algorythmics/pianoplayer/hardware/dev_boards/readme.md

# Hardware Development Boards

Replacement for old Escher boards are developed here.
