algorythmics/pianoplayer/hardware/federn/readme.rst

Feder für Rückhol der Hubmagnete
--------------------------------

Kantor
------

Spiralfeder klein (Neuhold standard)

Nachteil: ungenau, laut und schräge Zugkraft

Millittron
----------

ähnlich Kantor

Rhea
----

Black Knight Solenoids
    siehe Fotos

Neue Solenoids

  nach eigenbau mit Klavierdraht #4,
  neue laut zeichnung: formfeder_neu.jpg

    Federstahldraht 1.1211 
    EN 10218-2 Sorte D DIN 17223 T1 
    EN 10270-1DH 207’500 82’500   60° C  

    Alte Federn zu ungenau bei Zug.

  Problem: Materialermüdung (nach 10 Jahren bruch), klemmt leicht

  Neue Federn Faustenhammer
    Kegelstumpf siehe Rechnung und Anbaot
    
    500 Stk erste Serien    
    500 Stk Nachbestellung
