algorythmics/pianoplayer/hardware/escherFET16/readme.rst

escher FET16 - Power FET-Board for escher 1.0
=============================================

algorythmics 6.5.2008, winfried ritsch (see changelog in svn for more)

:board design, first production: Michael Klamminger
:Version: $Revision: 1.0, 1.1 (little modification)

For more info see at [algo_escher]_ 

main features
-------------

- FET-driver ZXGD3002E6  11ns, 9A peak [FETDRIVER]_  for fast switching applications

- 16 N-Channel [FET]_ RTR040N03 30V/4A,16A peak

- usage of ribbon cable connectors

- Voltage regulator for FET-driver supply

- 2 status LEDs

- 2 boards connectable to one escher

- power supply of drivers either externel or from/to escher board

Contents:
---------

board
	eagle board data
	
doc
	collection of documentation on some features
	
figures
	figures, schematics, as images
	
Notes
-----

- Altenative FETs: RSR030n06 60V/3A

.. [algo_escher] homepage: http://algo.mur.at/projects/microcontroller/escher/

.. [FETDRIVER] http://www.diodes.com/products/catalog/detail.php?item-id=820

.. [FET] http://www.rohm.com/products/discrete/transistor/mosfet/rtr040n03/
