algorythmics/pianoplayer/hardware/solenoids/readme.txt

V1:  black knights 7W/12V

V2: Yaxin Sonderfertigung fuer Algorythmics 1000Stk siehe Plan
