algorythmics/pianoplayer/doku/kantor_first_prototype/readme.rst

Kantor
======

First Prototype of Autoklavierspieler, 120kg weight and 3KW of power, played first quadraduren with
Kendrion relais, later Binder-Relais and hand soldered PIC boards on laboratory pcbs.

Schematics is documented in parts, but not whole, also LEDs has been added.

The firmware was written with Michrochips MPLab IDE.

Some Data:

Used solenoids:  Kendrion Gleichstr.Hubmagn. Zyp 40E006-25A58 (24V/8mm) 
 
"Der Gleichstrom-Einfachhubmagnet ist ein Magnet in geschlossener Bauweise mit Anker, gestanztem Bügel und 2 Platten -  ED 100% 24V-13,5W"

KENDRION Binder Magnete Ges.m.b.H, 8552 Eibiswald 269, Austria
