algorythmics/pianoplayer/hardware/escherFET16/docu/readme.txt

furhter documents are under  http://algo.mur.at/projects/microcontroller/escher/devel/fet-experiments
private.

measurement_knights_solenoids
 first measurements pulswith with Resistor and "balck Knights" 12V (100%ED) solenoids on 30V
 
 30V means 16% ED max or 625% of nominal power.
 risetime: 150ns, fall time 100ns allows smallest pulse at 4MHz, which means < 1/200 as first step.
