algorythmics/pianoplayer/hardware/escherFET16/figures/fet16-pinout.pdf

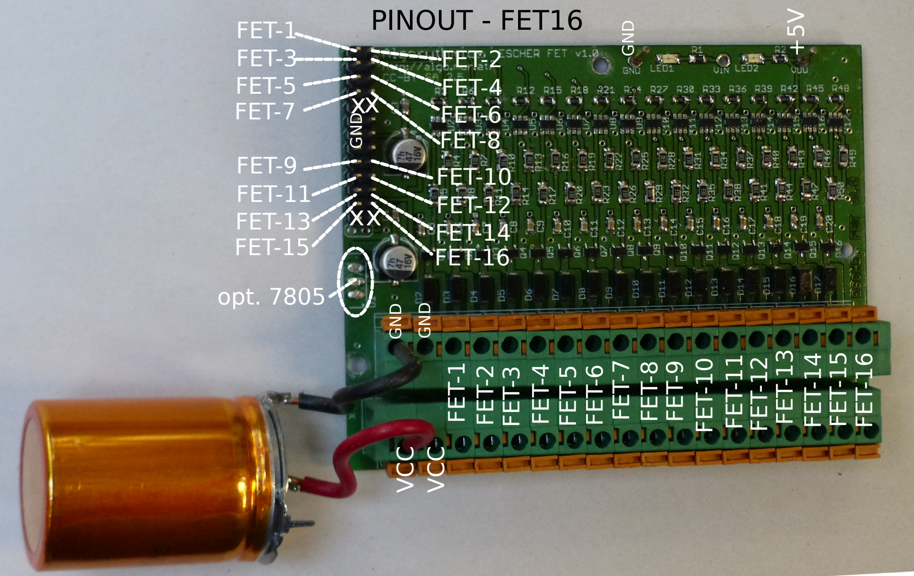
[picture p2: page 1]

FET-1
FET-3
FET-5
FET-7

FET-9
FET-11
FET-13
FET-15

### xxGND

FET-2
FET-4
FET-6
FET-8
FET-10
FET-12
FET-14

# FET-16 FET⁻1 FET⁻3

FET-5

FET-7
FET-9
FET-2

FET-4
FET-6

FET-8

FET-10

FET-11
FET-12

FET-13
FET-14

FET-15
FET-16

### VCC GND

## GND VCC

GND

+5V

xx

### PINOUT - FET16

opt. 7805
