algorythmics/pianoplayer/doku/idea_of_a_piano_space.pdf

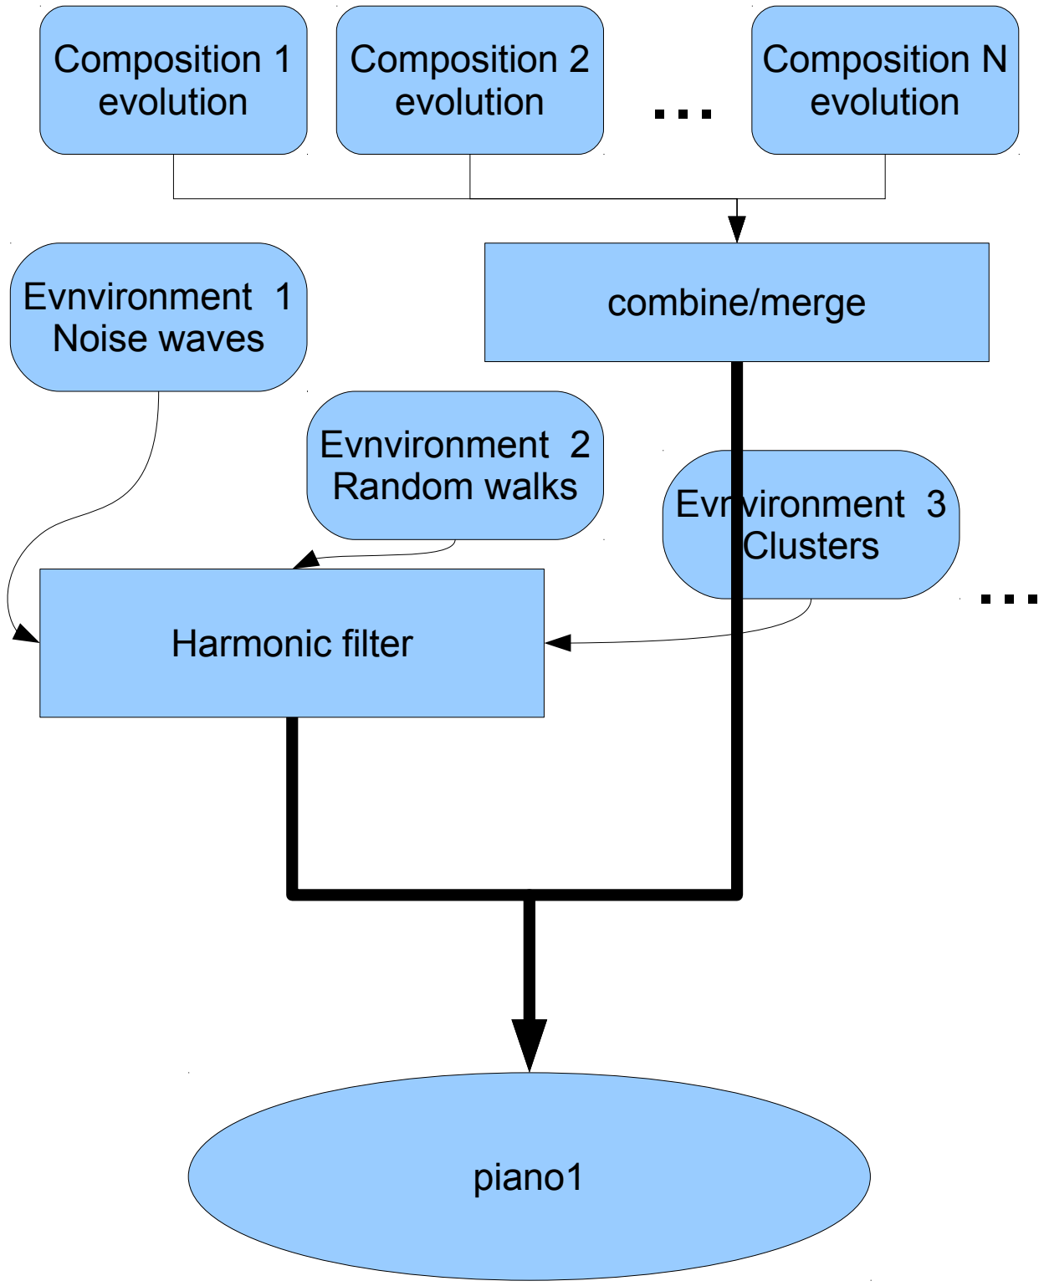
[picture p3: figure]
piano1; Composition 1 evolution; Composition 2; evolution; Composition N evolution; Evnvironment 1 Noise waves; Evnvironment 2; Random walks; Evnvironment 3; Clusters; combine/merge; Harmonic filter

One piano space for parallel pieces

voices
