algorythmics/pianoplayer/hardware/solenoids/hubmagnete_messurements-for_firmware.ods

Sheet: calculations
Watt und Leistung
7 W Hubmagnet 12V |  |  |  |  |  | 4 W Hubmagnet -12V
 | U | P (W) | R | I |  |  | U | P (W) | R | I
Angabe | 12 | 7 | 20,5714285714 | 0,5833333333 |  | Angabe | 12 | 4 | 36 | 0,3333333333
Bei | 30 | 43,75 | 20,5714285714 | 1,4583333333 | 16,00% | Bei | 30 | 25 | 36 | 0,8333333333 | 16,00%
 | 20 | 19,4444444444 | 20,5714285714 | 0,9722222222 |  |  | 20 | 11,1111111111 | 36 | 0,5555555556
 | 32 | 49,7777777778 | 20,5714285714 | 1,5555555556 |  |  | 32 | 28,4444444444 | 36 | 0,8888888889
7 W Hubmagnet – 6V |  |  |  |  |  | 4 W Hubmagnet – 6V
 | U | P (W) | R | I (A) |  |  | U | P (W) | R | I
Angabe | 6 | 7 | 5,1428571429 | 1,1666666667 |  | Angabe | 6 | 4 | 9 | 0,6666666667
Bei | 30 | 175 | 5,1428571429 | 5,8333333333 | 4,00% | Bei | 30 | 100 | 9 | 3,3333333333 | 4,00%
 | 20 | 77,7777777778 | 5,1428571429 | 3,8888888889 |  |  | 20 | 44,4444444444 | 9 | 2,2222222222
 | 16 | 49,7777777778 | 5,1428571429 | 3,1111111111 |  |  | 32 | 113,7777777778 | 9 | 3,5555555556
Impuls |  | 10 | 50 | 20,00%
 |  |  | Ieinzel(A) | I(A) | U(V) | P (W)
Gesamt Leistung |  |  | 3 | 264 | 16 | 4224
 |  |  |  | 52,8 | 16 | 422,4
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
