algorythmics/pianoplayer/doku/kantor_first_prototype/Idee-Steuerung.pdf

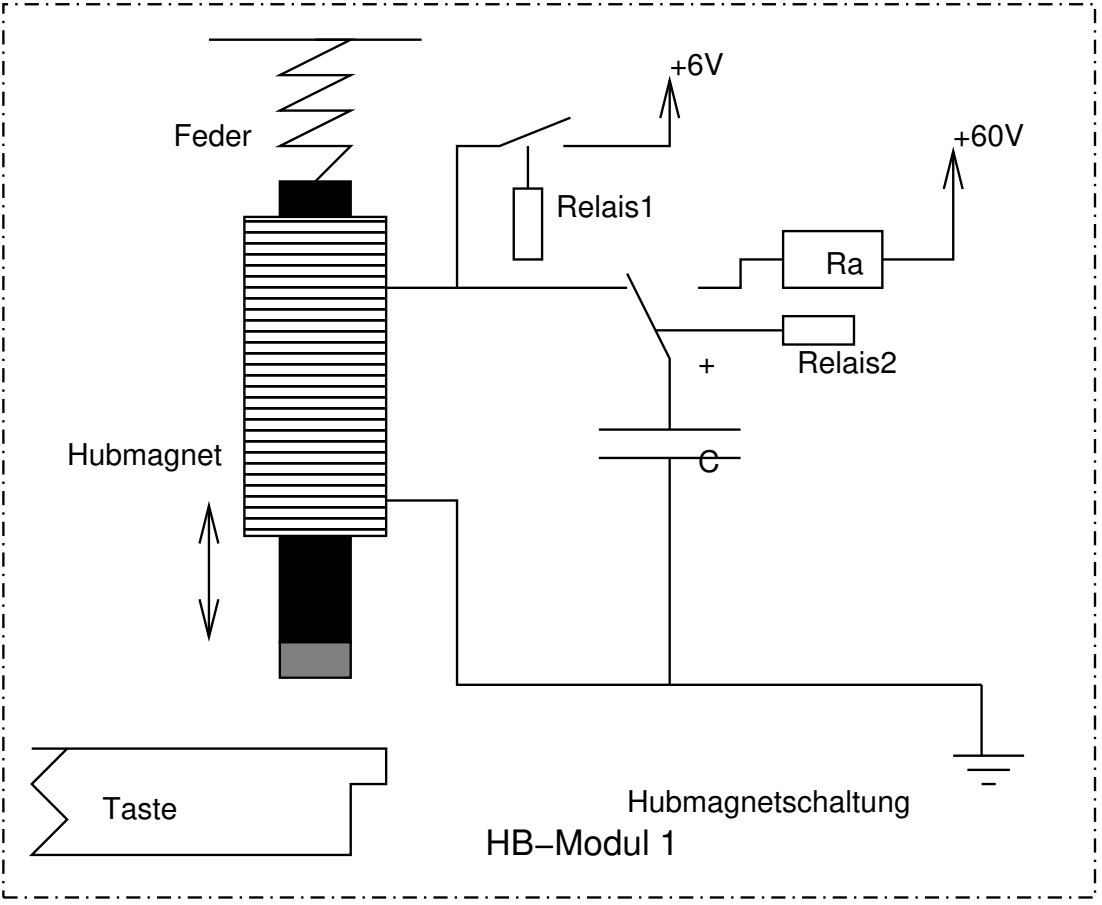
[picture p4: figure]
Taste; Feder; Hubmagnet; Relais1; Relais2; Hubmagnetschaltung HB−Modul 1
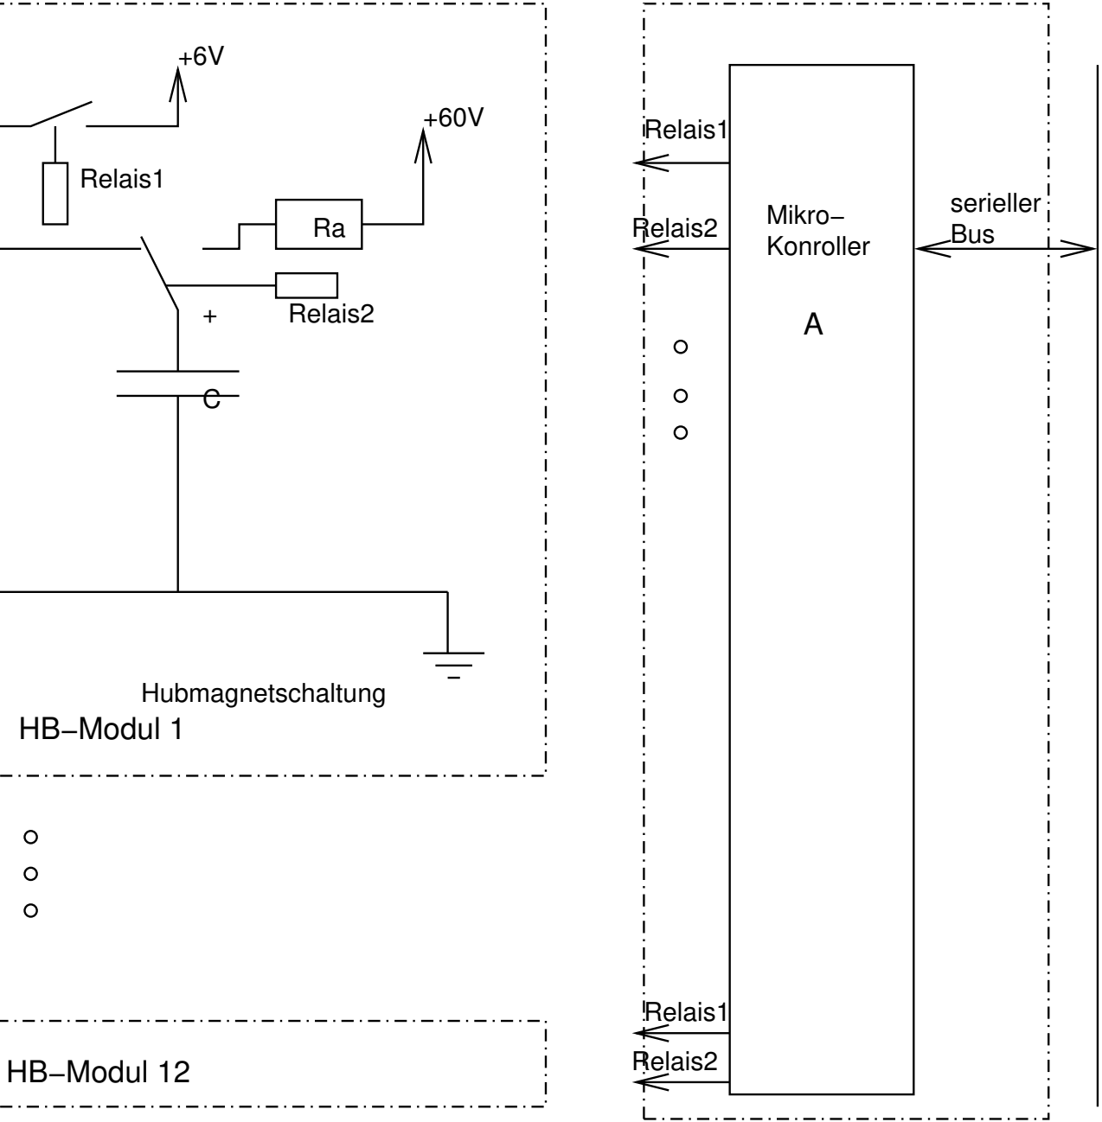
[picture p5: figure]
Mikro− Konroller Relais2; Relais1; serieller Bus; HB−Modul 12; Relais2
