algorythmics/pianoplayer/hardware/doku/tastenabstaende.ods

Sheet: Allgemein
Einheiten
 | mm | Tastenbreiten | Tastenbreiten | Tastenbreiten | Tastenbreiten
 | je inch | bei 85 Tasten | je Oktave | 7 Oktaven | bei 88 Tasten
 | 25,4 | 50 | 7 | 49 | 52
Format | inch/Octave | inch/Taste | inch / 85 Tasten | mm/Octave | mm/Taste | mm/85 Tasten | mm/88Tasten
Standard | 6,5 | 0,93 | 46,43 | 165,1 | 23,5857 | 1155,7 | 1226,46
gemessen | 6,48 | 0,93 | 46,26 | 164,5 | 23,5000 | 1182 | 1222 | Yamaha
SD Standard | 6 | 0,86 | 42,86 | 152,4 | 21,7714 | 1066,8 | 1132,11
small | 5,11 | 0,73 | 36,5 | 129,79 | 18,5420 | 908,56 | 964,18
large | 7,04 | 1,01 | 50,29 | 178,82 | 25,5451 | 1251,71 | 1328,35
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
