algorythmics/pianoplayer/doku/kantor_first_prototype/fotos/00b_first_version-microcontroller_pic16f877.jpg

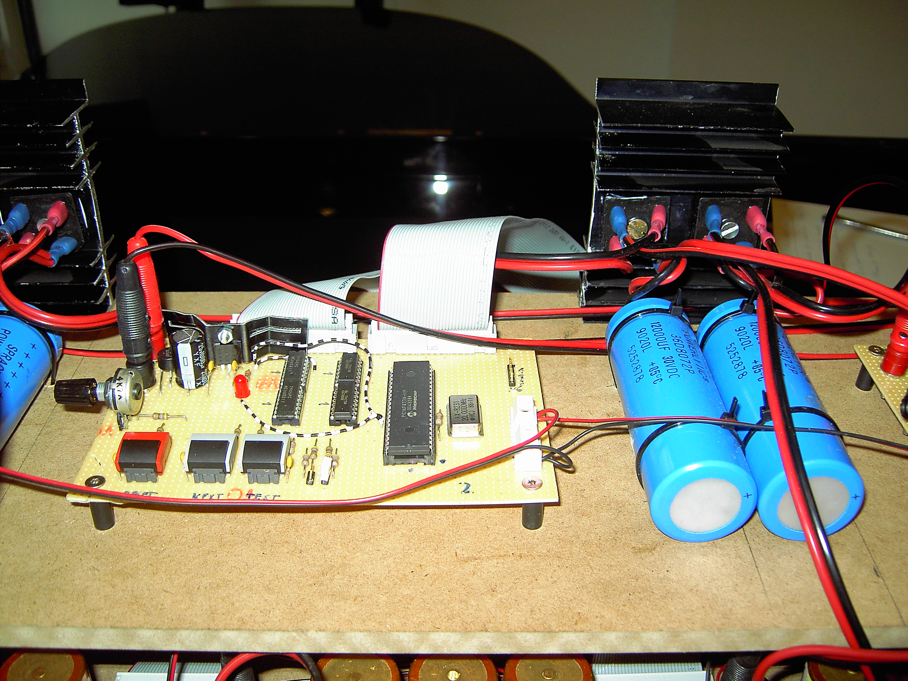
doku/kantor_first_prototype/fotos/00b_first_version-microcontroller_pic16f877.jpg
