algorythmics/pianoplayer/doku/kantor_first_prototype/fotos/00c-FET-board_for_one_octavepict0019.jpg

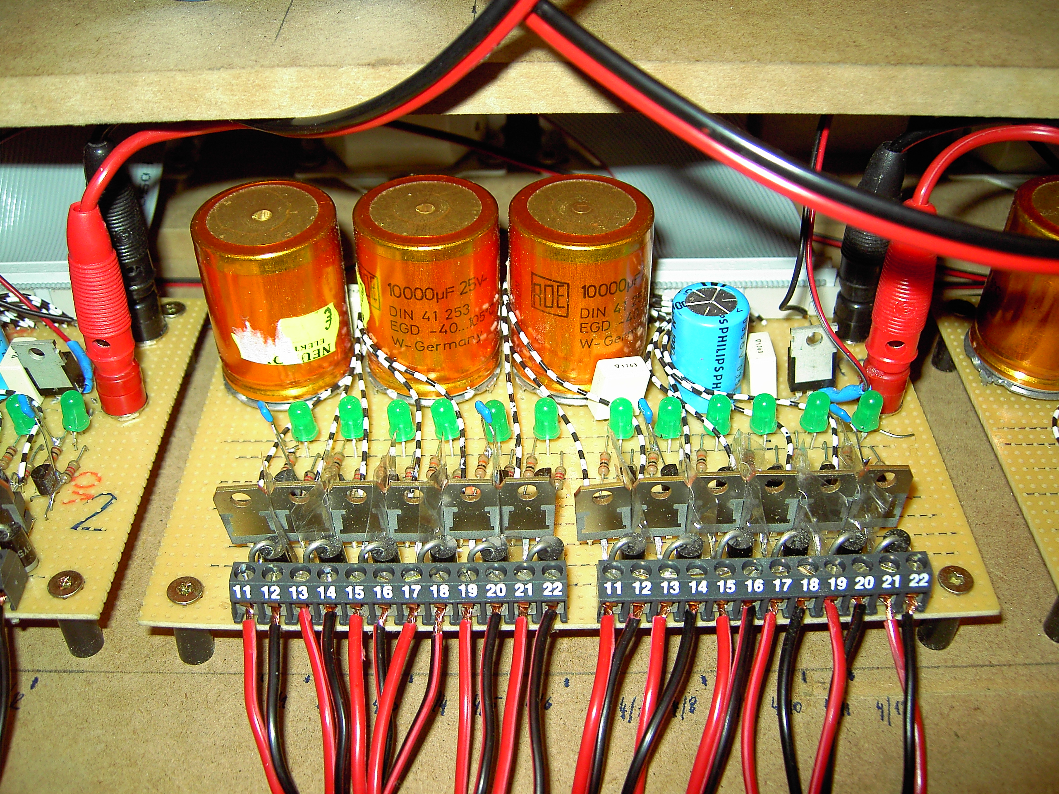
doku/kantor_first_prototype/fotos/00c-FET-board_for_one_octavepict0019.jpg
