algorythmics/pianoplayer/doku/kantor_first_prototype/fotos/00d-firstfinger_with_platic_tips.jpg

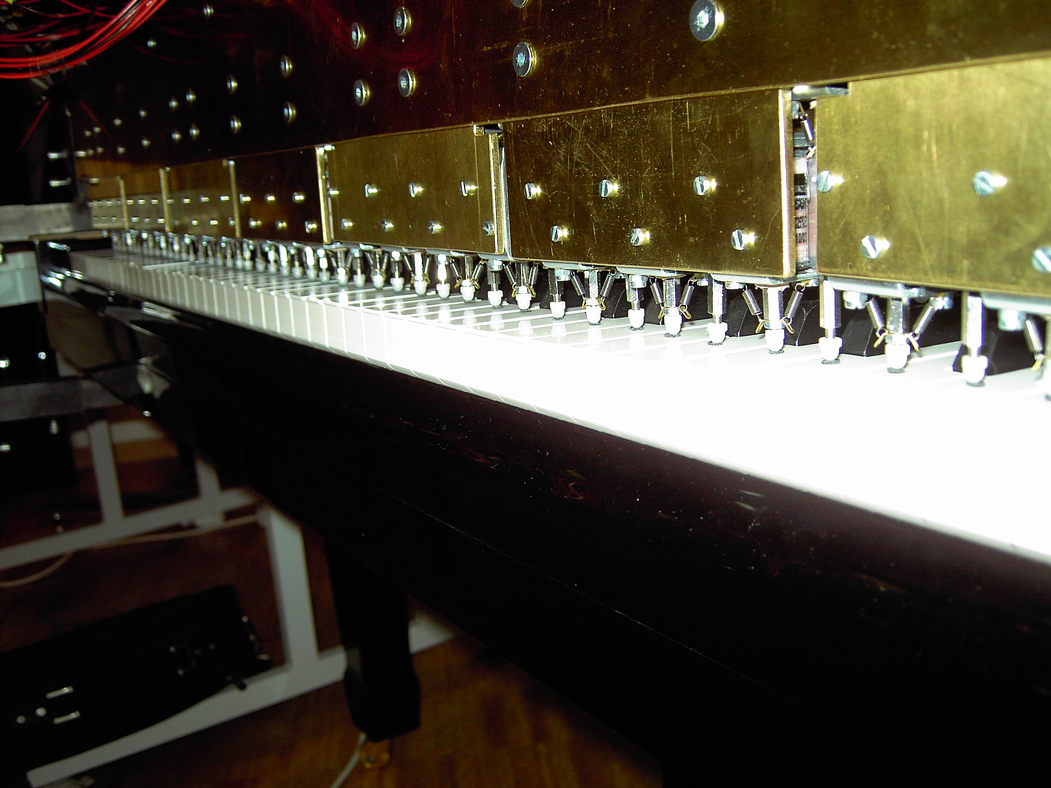
doku/kantor_first_prototype/fotos/00d-firstfinger_with_platic_tips.jpg
