algorythmics/pianoplayer/doku/kantor_first_prototype/fotos/00e-after_first_experiements.jpg

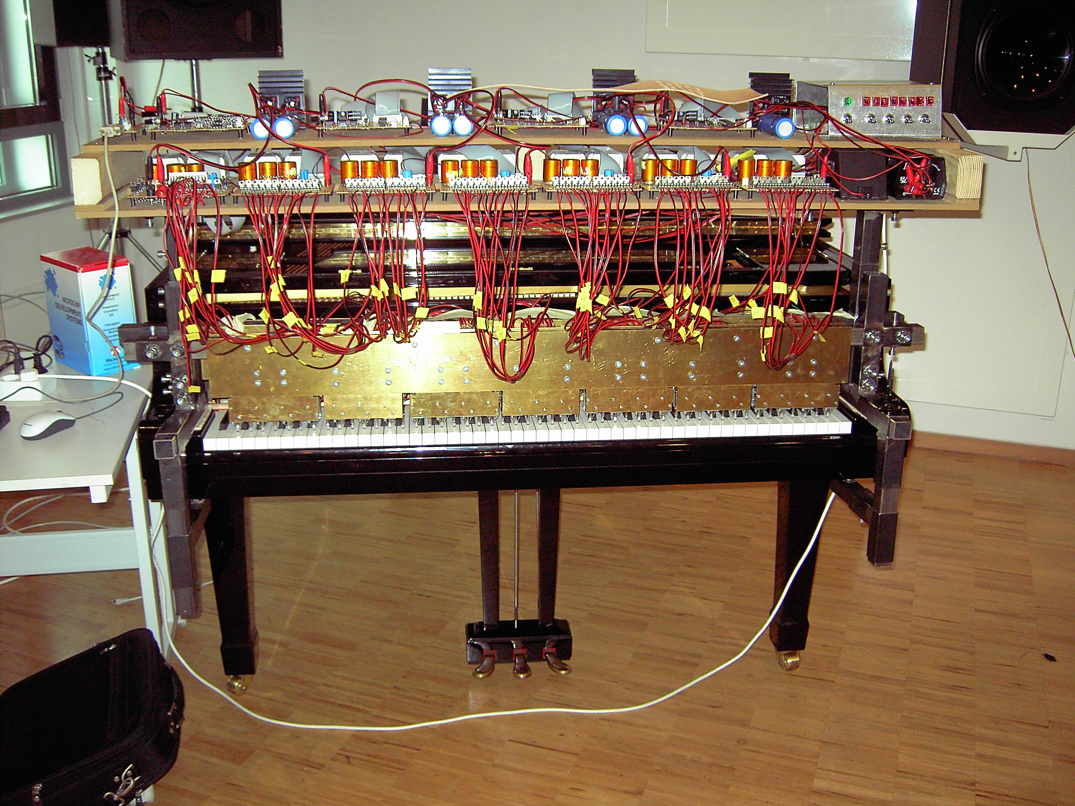
doku/kantor_first_prototype/fotos/00e-after_first_experiements.jpg
