algorythmics/pianoplayer/doku/kantor_first_prototype/fotos/01a-first_playing_prototype_for_prgrammung.jpg

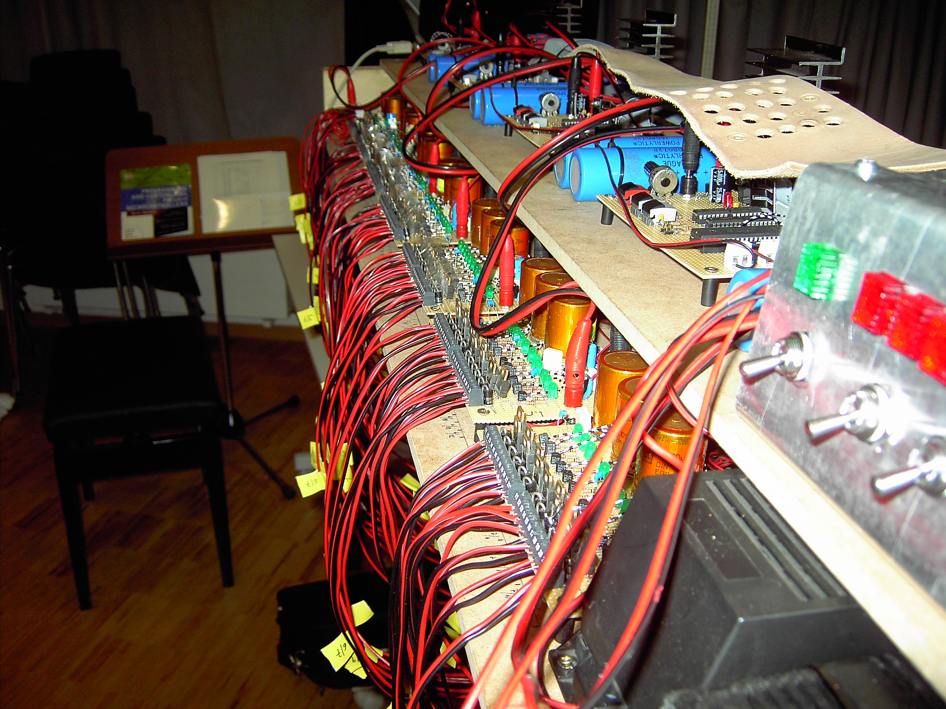
doku/kantor_first_prototype/fotos/01a-first_playing_prototype_for_prgrammung.jpg
