algorythmics/pianoplayer/doku/kantor_first_prototype/fotos/01b-new-brass_finger_with_felt.jpg

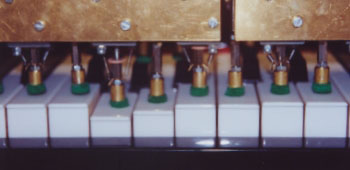
doku/kantor_first_prototype/fotos/01b-new-brass_finger_with_felt.jpg
