algorythmics/pianoplayer/doku/kantor_first_prototype/fotos/01c-finger_mounted_for_each_octave.jpg

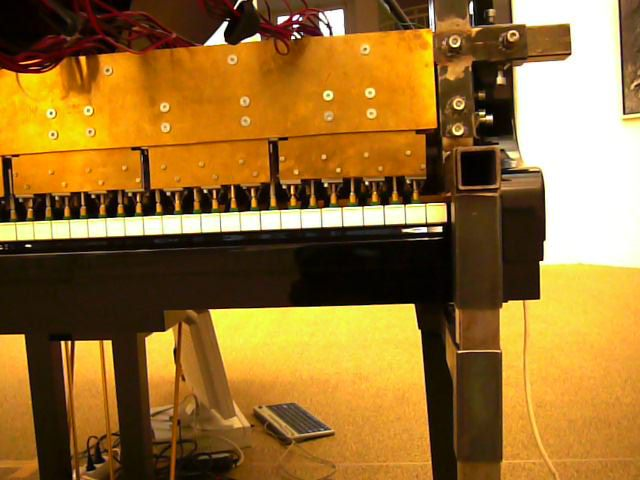
doku/kantor_first_prototype/fotos/01c-finger_mounted_for_each_octave.jpg
