algorythmics/pianoplayer/doku/kantor_first_prototype/fotos/01d-prepared_for_first_concert.jpg

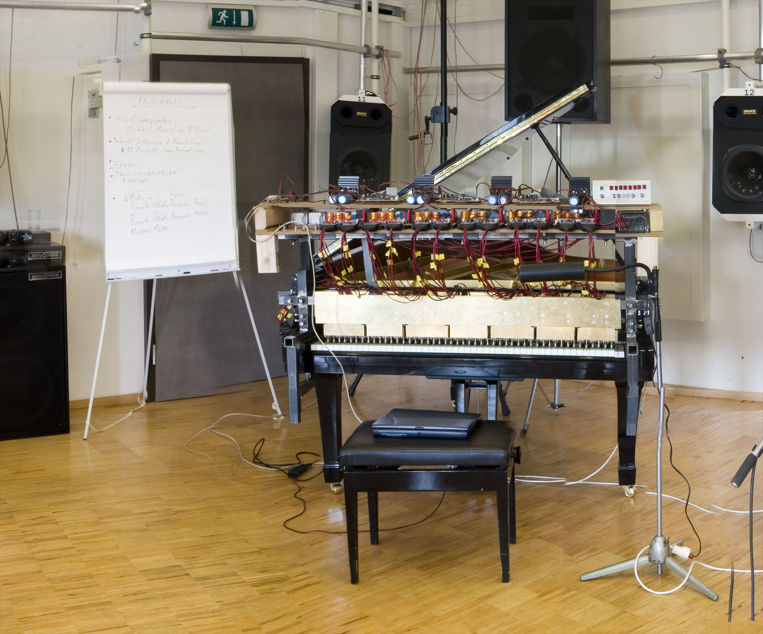
doku/kantor_first_prototype/fotos/01d-prepared_for_first_concert.jpg
