algorythmics/pianoplayer/doku/kantor_first_prototype/fotos/02-concert_in_minoriten_as_premiere.jpg

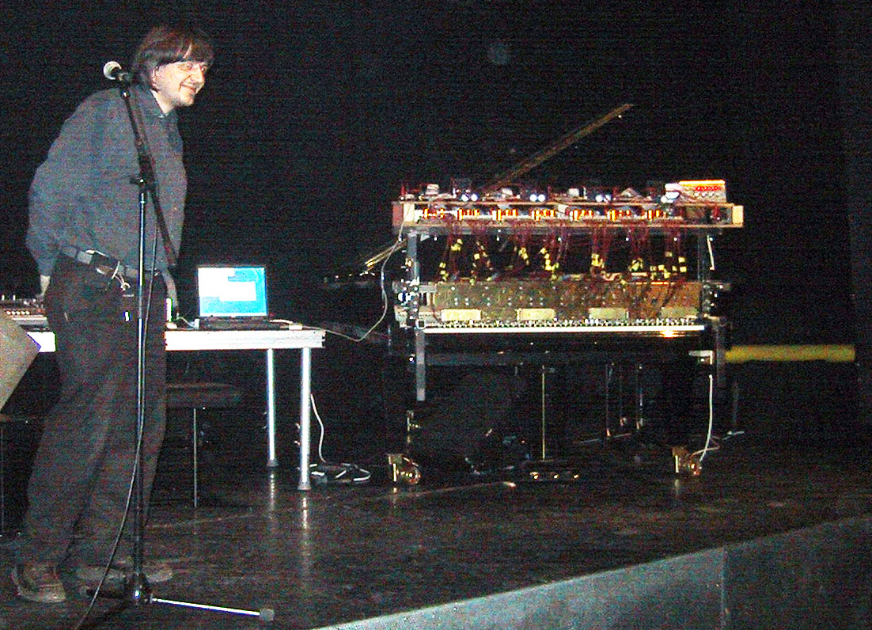
doku/kantor_first_prototype/fotos/02-concert_in_minoriten_as_premiere.jpg
