algorythmics/pianoplayer/doku/kantor_first_prototype/fotos/03a-playing_on_stage_in_listhalle_for_opera.jpg

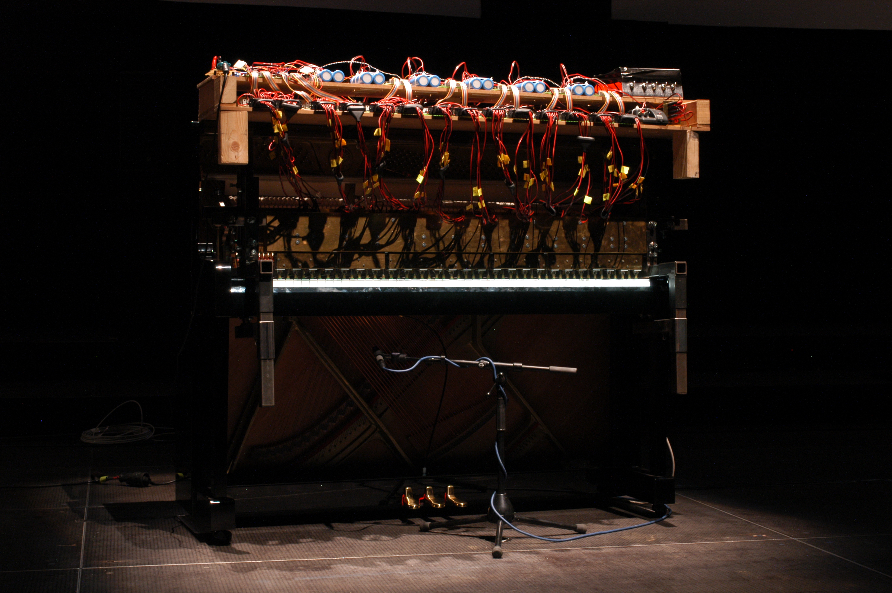
doku/kantor_first_prototype/fotos/03a-playing_on_stage_in_listhalle_for_opera.jpg
