algorythmics/pianoplayer/doku/kantor_first_prototype/fotos/03c-playing_on_stage_in_listhalle_with_movie.jpg

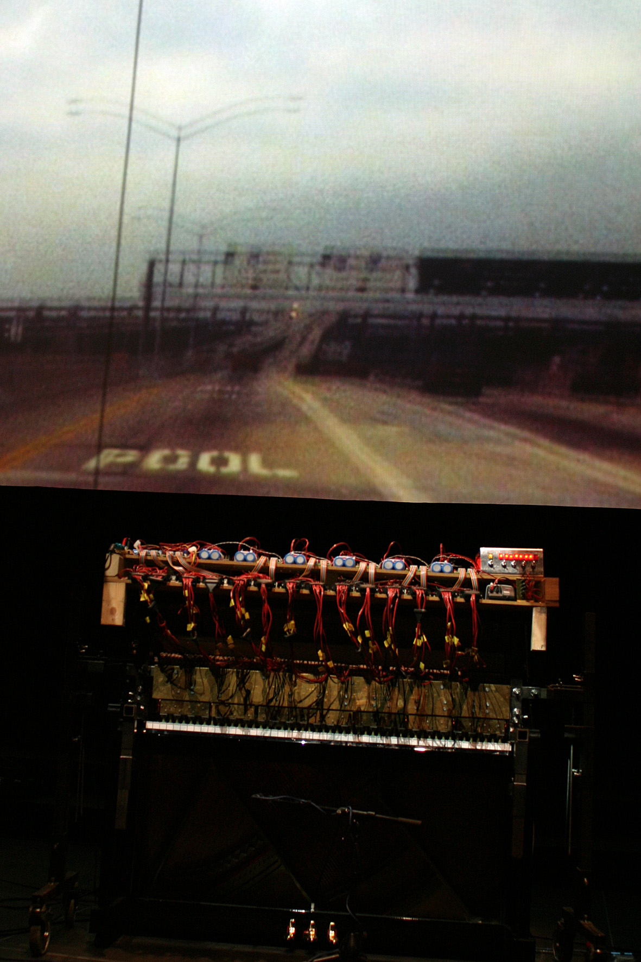
doku/kantor_first_prototype/fotos/03c-playing_on_stage_in_listhalle_with_movie.jpg
