algorythmics/pianoplayer/doku/kantor_first_prototype/fotos/03d-playing_on_stage_in_listhalle_with-ensembles_and_millitron.jpg

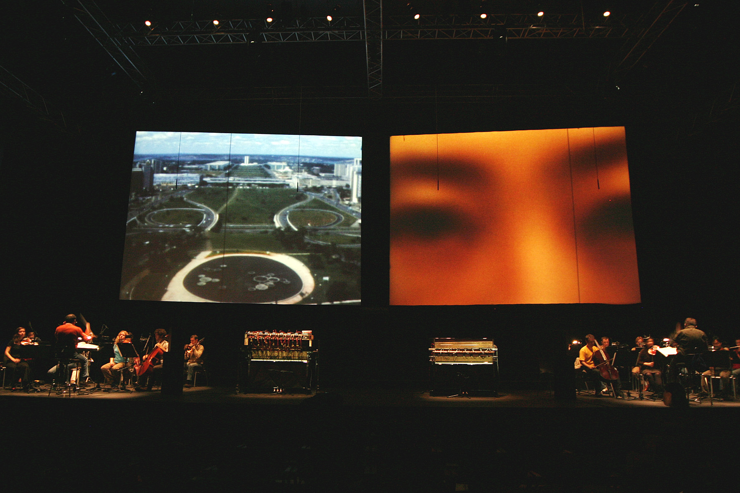
doku/kantor_first_prototype/fotos/03d-playing_on_stage_in_listhalle_with-ensembles_and_millitron.jpg
