algorythmics/pianoplayer/doku/kantor_first_prototype/fotos/04-playing_interactive_in_kunsthaus-graz.jpg

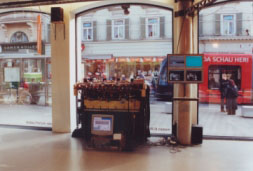
doku/kantor_first_prototype/fotos/04-playing_interactive_in_kunsthaus-graz.jpg
