algorythmics/pianoplayer/doku/kantor_first_prototype/schaltungen_entwurf/icdconnect.png

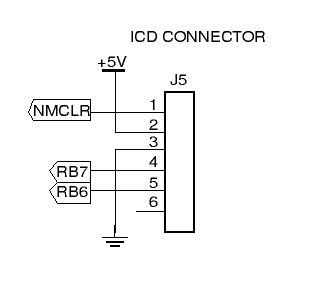
doku/kantor_first_prototype/schaltungen_entwurf/icdconnect.png
