algorythmics/pianoplayer/doku/kantor_first_prototype/schaltungen_entwurf/oszi.png

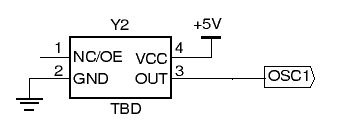
doku/kantor_first_prototype/schaltungen_entwurf/oszi.png
