algorythmics/pianoplayer/doku/kantor_first_prototype/schaltungen_entwurf/PIC16F877Apinout.png

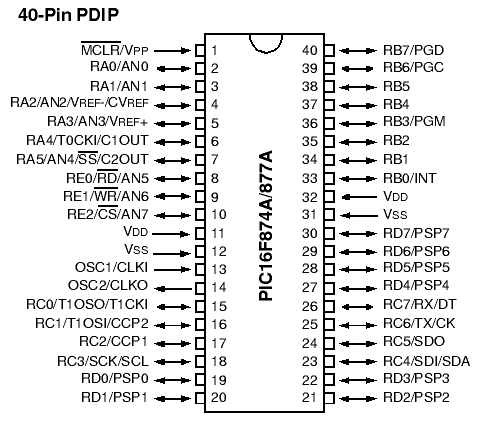
doku/kantor_first_prototype/schaltungen_entwurf/PIC16F877Apinout.png
