algorythmics/pianoplayer/doku/kantor_first_prototype/schaltungen_entwurf/schalter_ra_port.png

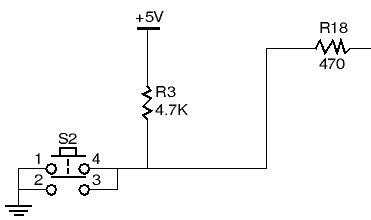
doku/kantor_first_prototype/schaltungen_entwurf/schalter_ra_port.png
