algorythmics/pianoplayer/doku/kantor_first_prototype/schaltungen_entwurf/schalter_reset.png

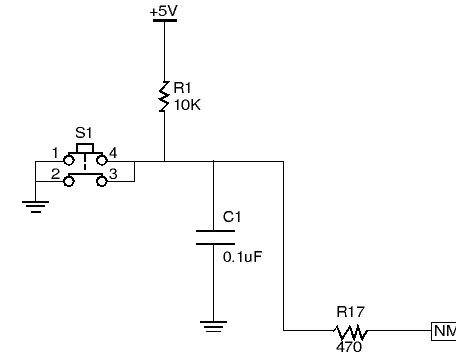
doku/kantor_first_prototype/schaltungen_entwurf/schalter_reset.png
