algorythmics/pianoplayer/doku/kantor_first_prototype/schaltungen_entwurf/seriell.png

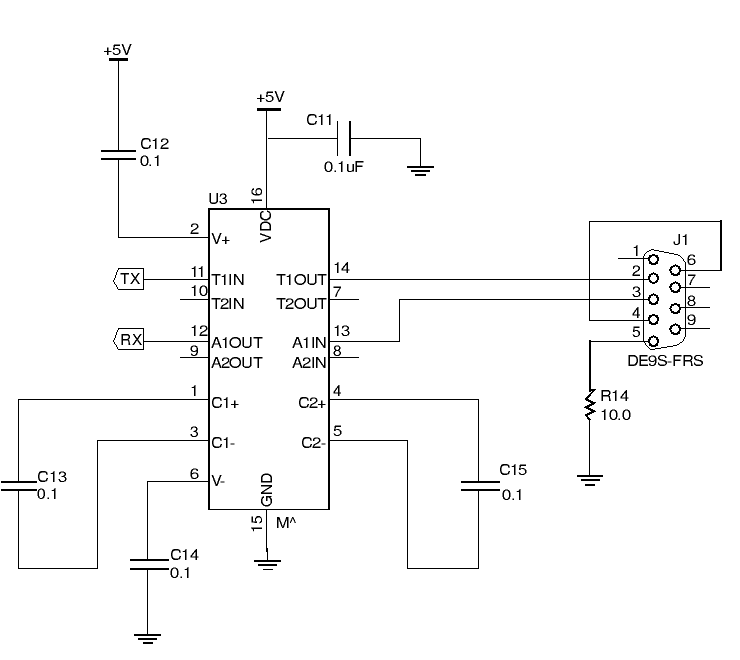
doku/kantor_first_prototype/schaltungen_entwurf/seriell.png
