algorythmics/pianoplayer/doku/kantor_first_prototype/schaltungen_entwurf/versorgung.png

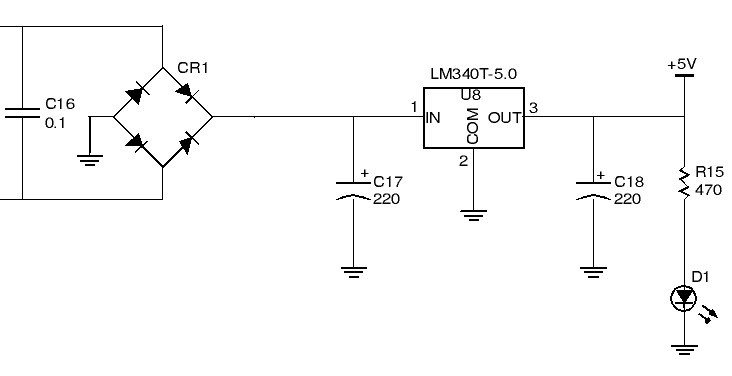
doku/kantor_first_prototype/schaltungen_entwurf/versorgung.png
