algorythmics/pianoplayer/doku/millitron_2nd_generation/fotos/02-listhalle_millitron.jpg

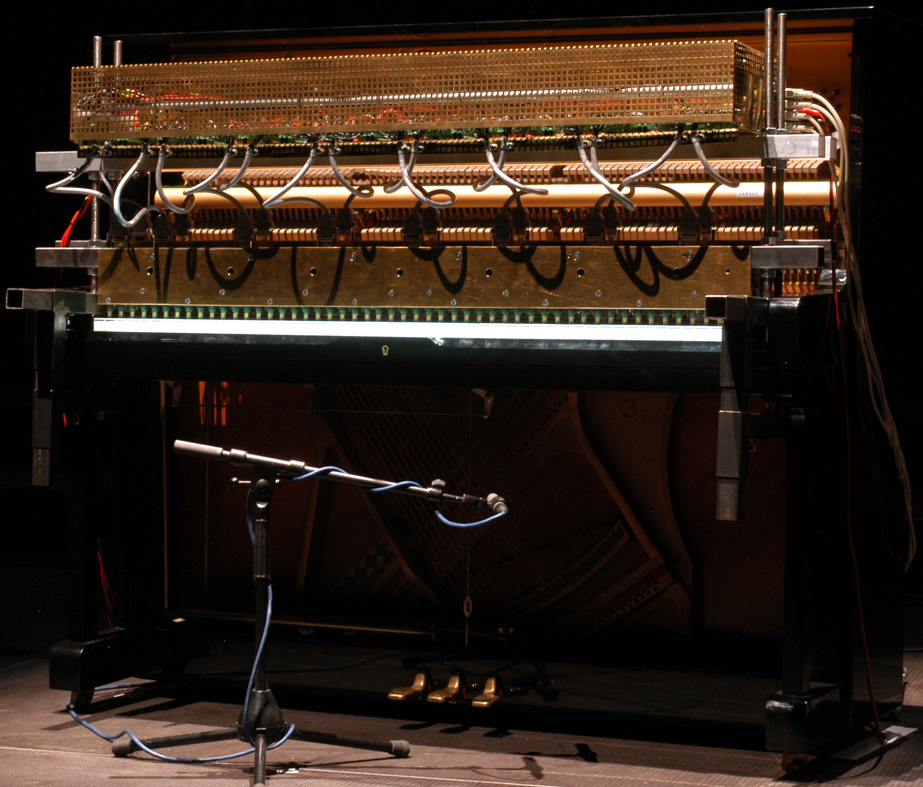
doku/millitron_2nd_generation/fotos/02-listhalle_millitron.jpg
