algorythmics/pianoplayer/doku/millitron_2nd_generation/fotos/03-finger.jpg

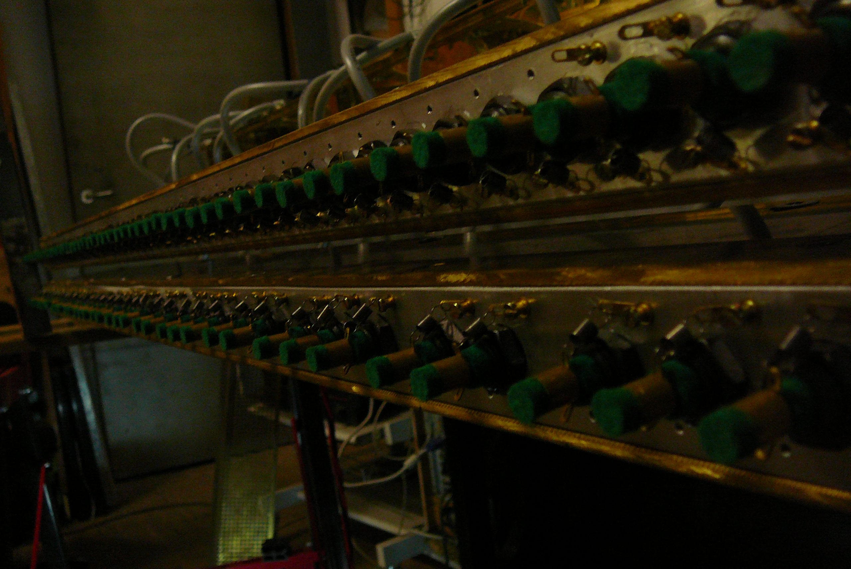
doku/millitron_2nd_generation/fotos/03-finger.jpg
