algorythmics/pianoplayer/doku/millitron_2nd_generation/fotos/04a-millitron_in_witten.jpg

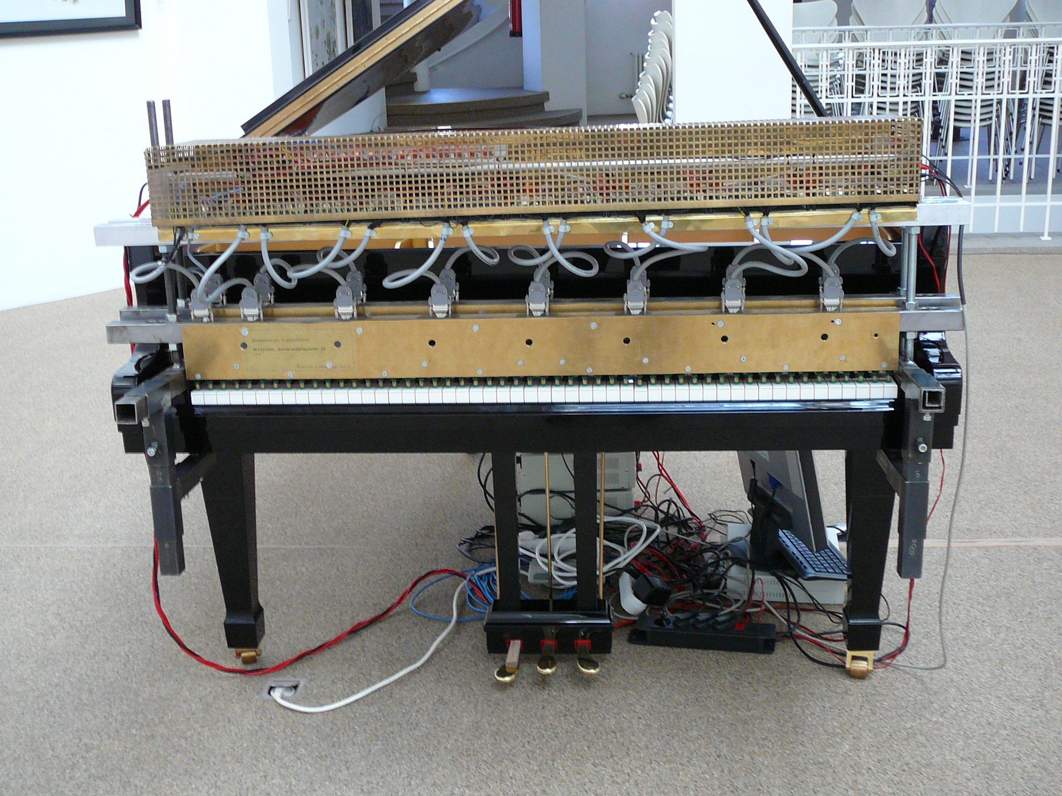
doku/millitron_2nd_generation/fotos/04a-millitron_in_witten.jpg
