algorythmics/pianoplayer/doku/millitron_2nd_generation/fotos/04c-millitron_in_witten_with_kantor.jpeg

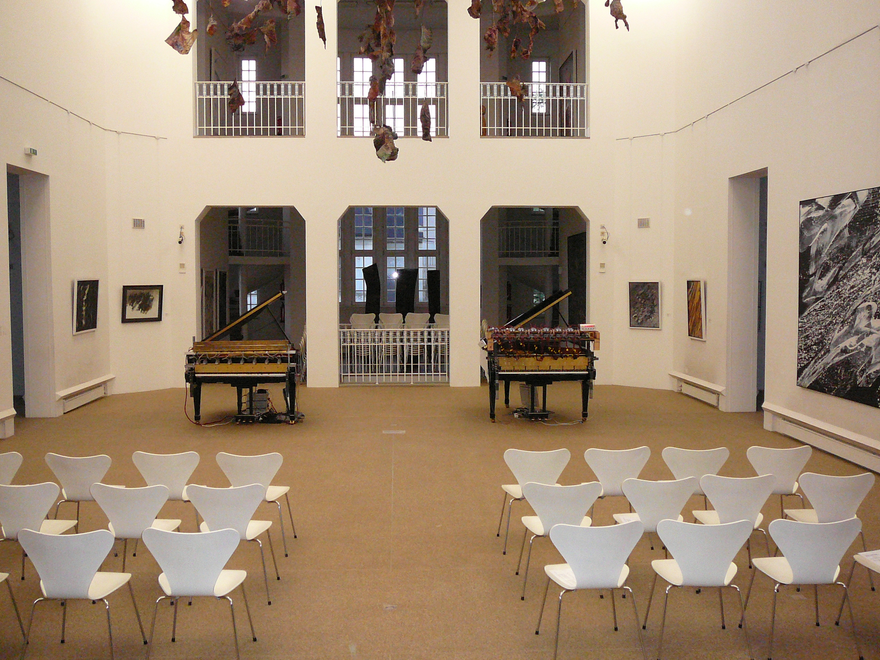
doku/millitron_2nd_generation/fotos/04c-millitron_in_witten_with_kantor.jpeg
