algorythmics/pianoplayer/doku/millitron_2nd_generation/fotos/04d-millitron_in_witten_with_kantor.jpg

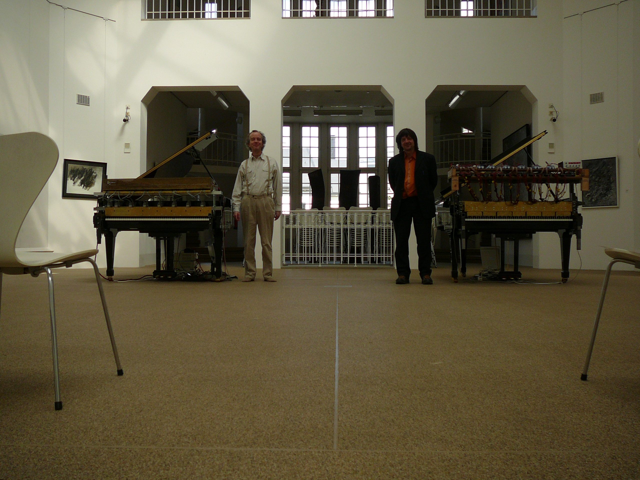
doku/millitron_2nd_generation/fotos/04d-millitron_in_witten_with_kantor.jpg
