algorythmics/pianoplayer/doku/one-hammer-piano_player-demo/IMG_20240417_135547.jpg

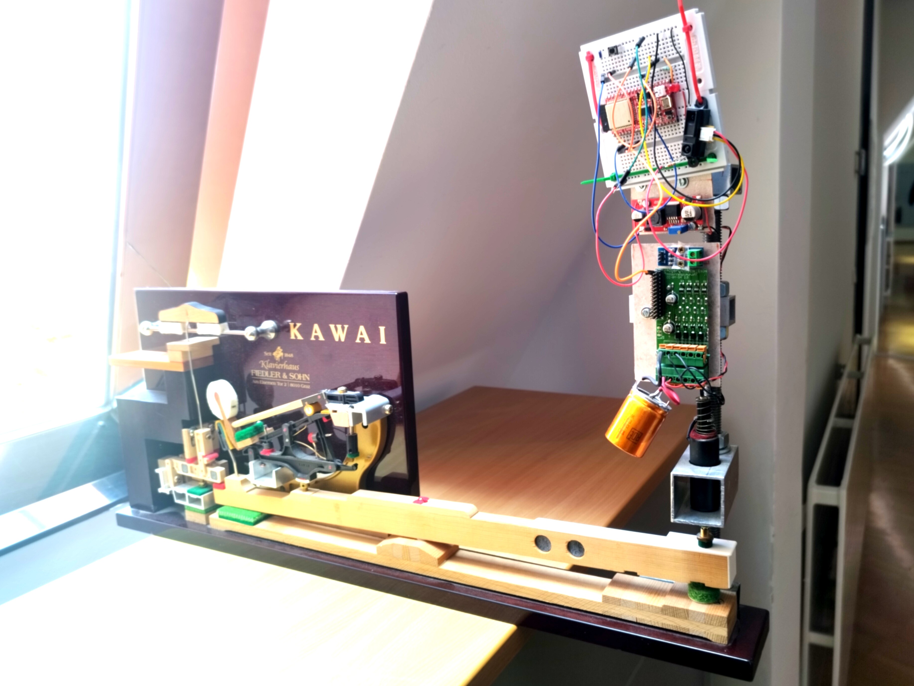
doku/one-hammer-piano_player-demo/IMG_20240417_135547.jpg
