algorythmics/pianoplayer/doku/rhea_3rd_generation/fotos/00d-rhea_v1-finger.jpg

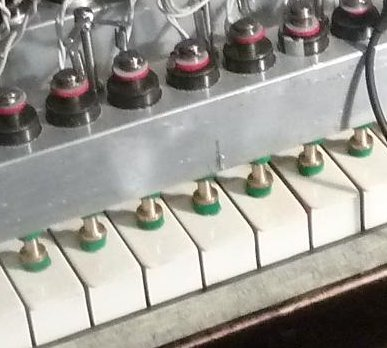
doku/rhea_3rd_generation/fotos/00d-rhea_v1-finger.jpg
