algorythmics/pianoplayer/doku/rhea_3rd_generation/fotos/00e-rhea_v1-prototype.jpg

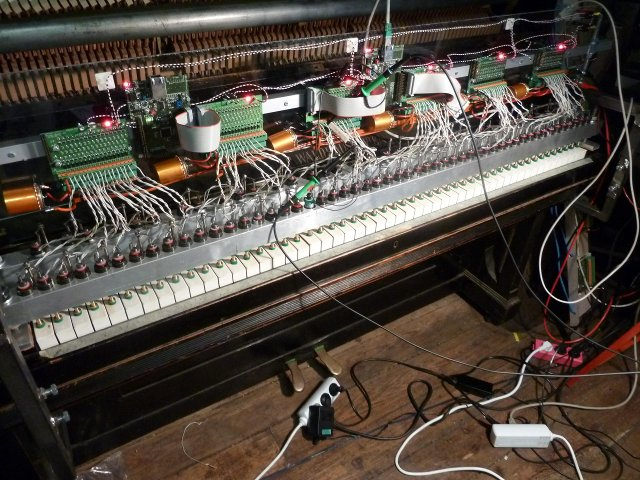
doku/rhea_3rd_generation/fotos/00e-rhea_v1-prototype.jpg
