algorythmics/pianoplayer/doku/rhea_3rd_generation/fotos/01-rhea_at_ars_electronica.jpg

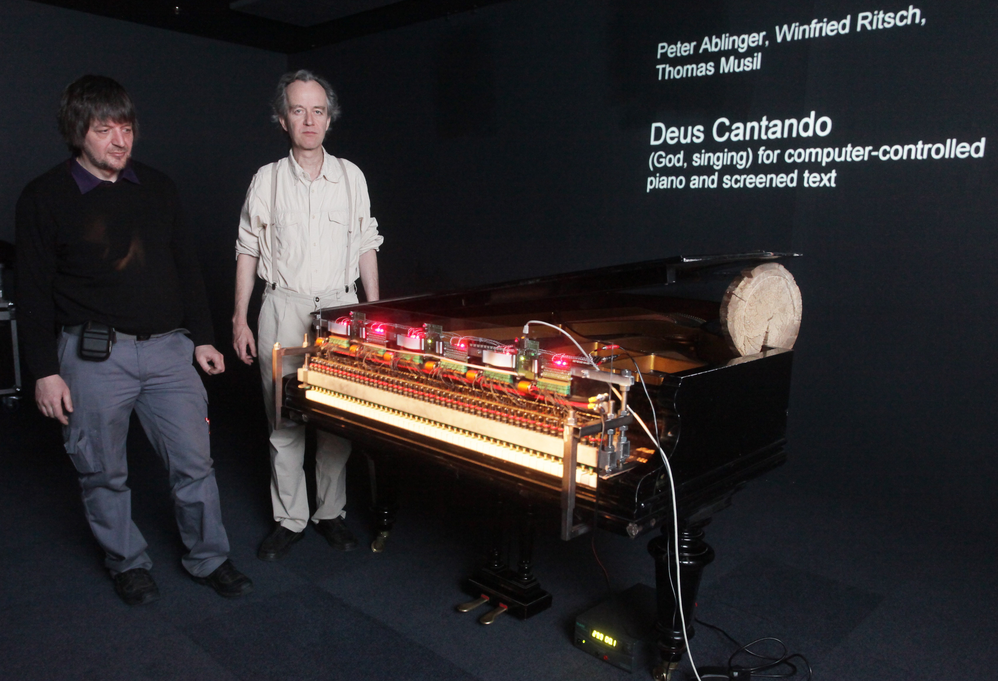
doku/rhea_3rd_generation/fotos/01-rhea_at_ars_electronica.jpg
