algorythmics/pianoplayer/doku/rhea_3rd_generation/fotos/02_rhea_in_shanghai.jpg

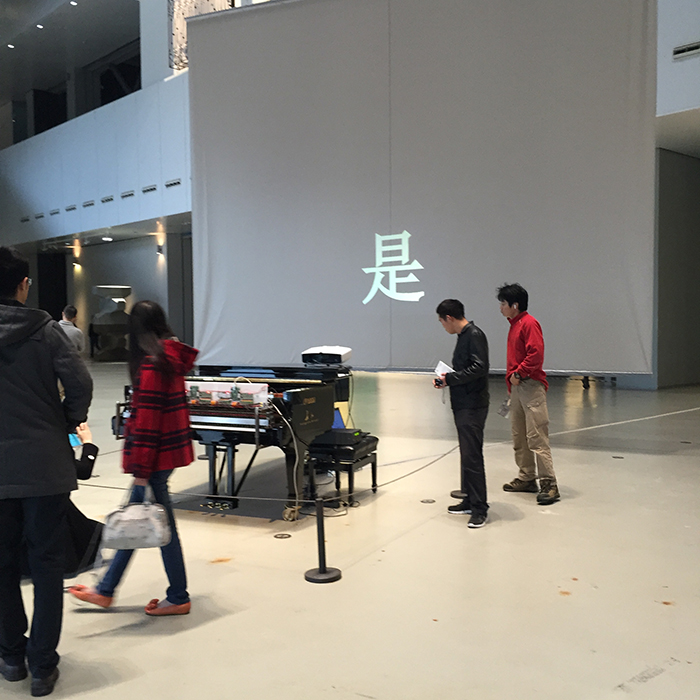
doku/rhea_3rd_generation/fotos/02_rhea_in_shanghai.jpg
