algorythmics/pianoplayer/doku/rhea_3rd_generation/fotos/04b-dancing_piano.jpeg

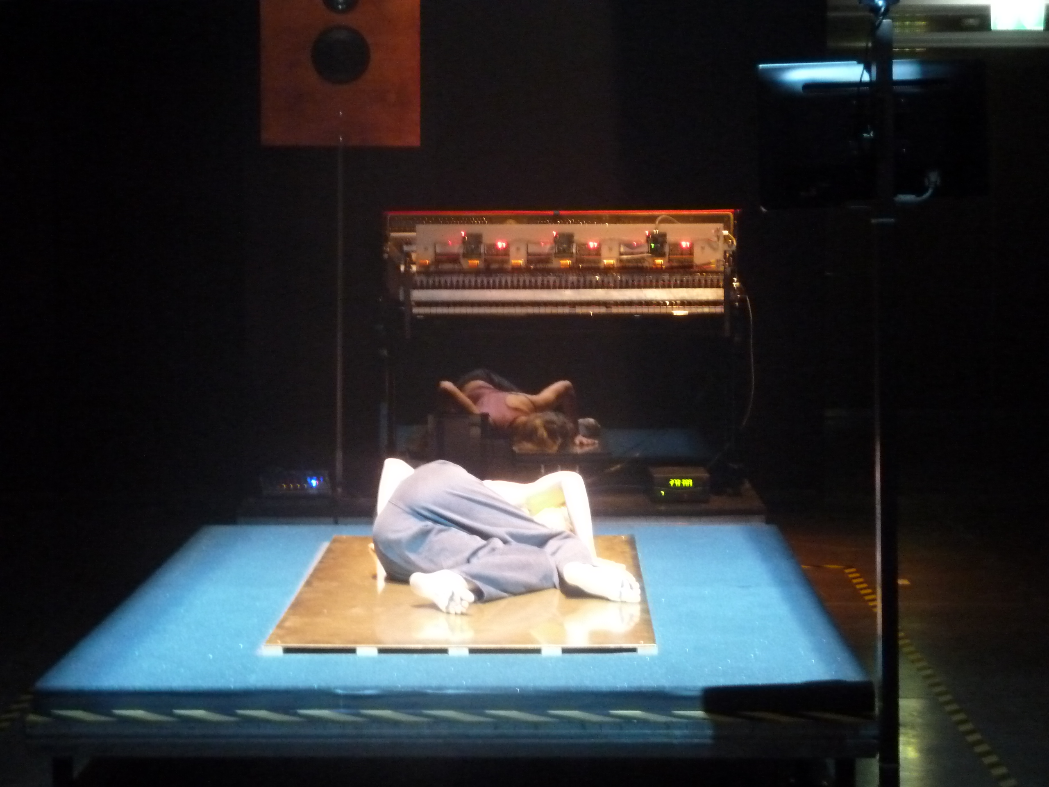
doku/rhea_3rd_generation/fotos/04b-dancing_piano.jpeg
