algorythmics/pianoplayer/doku/rhea_3rd_generation/fotos/04b_series_of_rheas.jpg

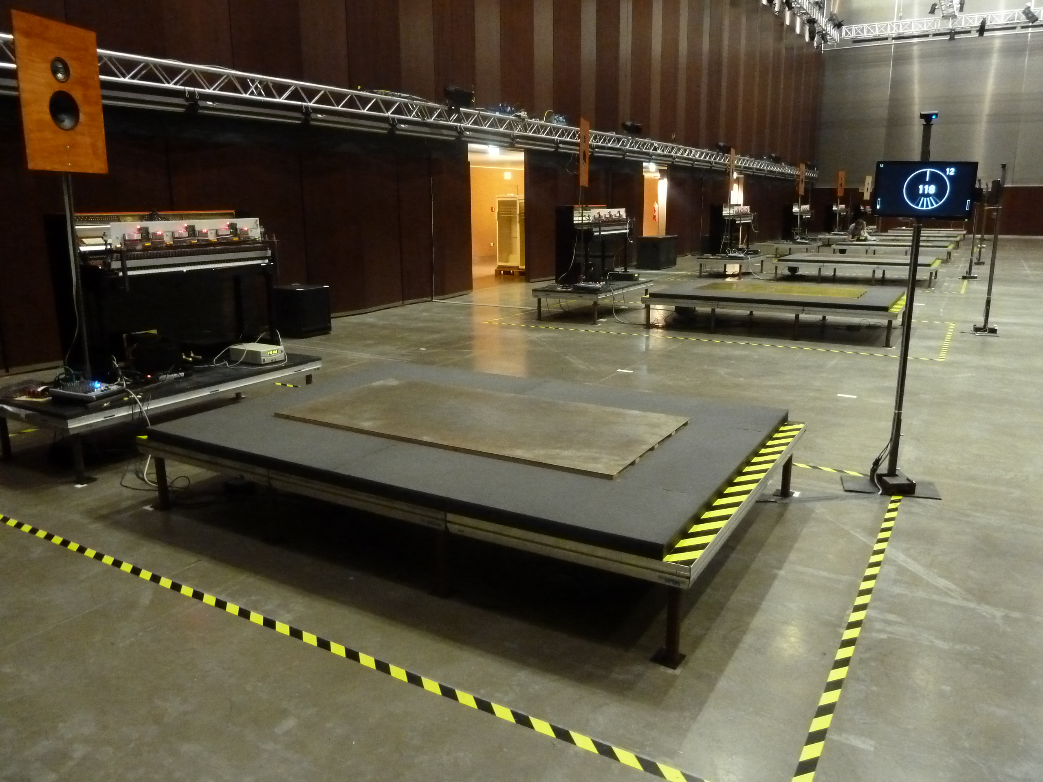
doku/rhea_3rd_generation/fotos/04b_series_of_rheas.jpg
