algorythmics/pianoplayer/doku/rhea_3rd_generation/verpackung/01_automat_cased.jpg

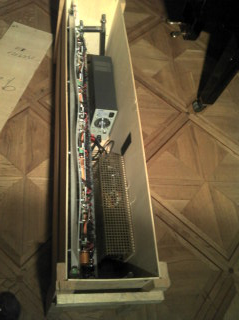
doku/rhea_3rd_generation/verpackung/01_automat_cased.jpg
