algorythmics/pianoplayer/doku/rhea_3rd_generation/verpackung/02_automat_cased_damped.jpg

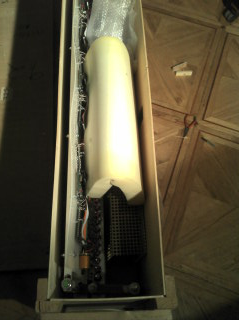
doku/rhea_3rd_generation/verpackung/02_automat_cased_damped.jpg
