algorythmics/pianoplayer/doku/rhea_3rd_generation/verpackung/03_automat_case_screw.jpg

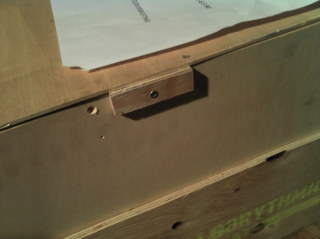
doku/rhea_3rd_generation/verpackung/03_automat_case_screw.jpg
