algorythmics/pianoplayer/hardware/dev_boards/img/STM32-butterfly_mounting-01.jpg

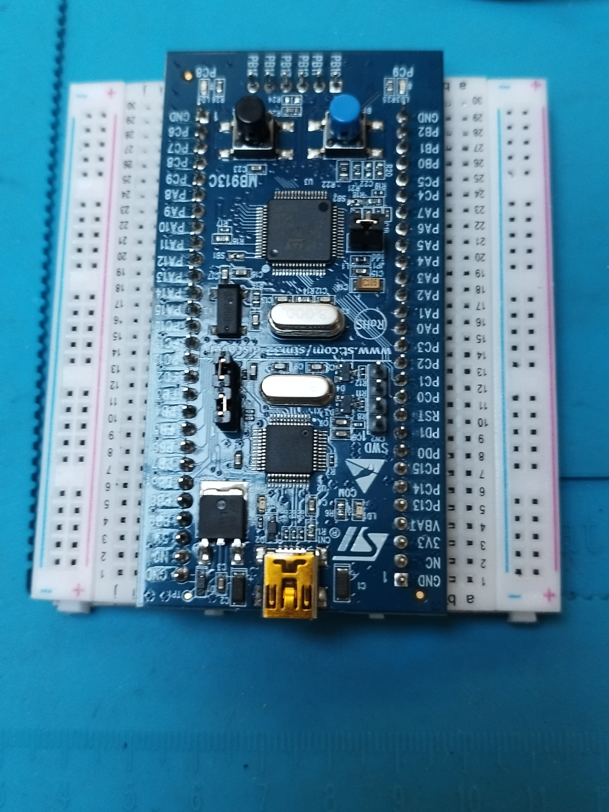
hardware/dev_boards/img/STM32-butterfly_mounting-01.jpg
