algorythmics/pianoplayer/hardware/dev_boards/img/STM32-butterfly_mounting-03.jpg

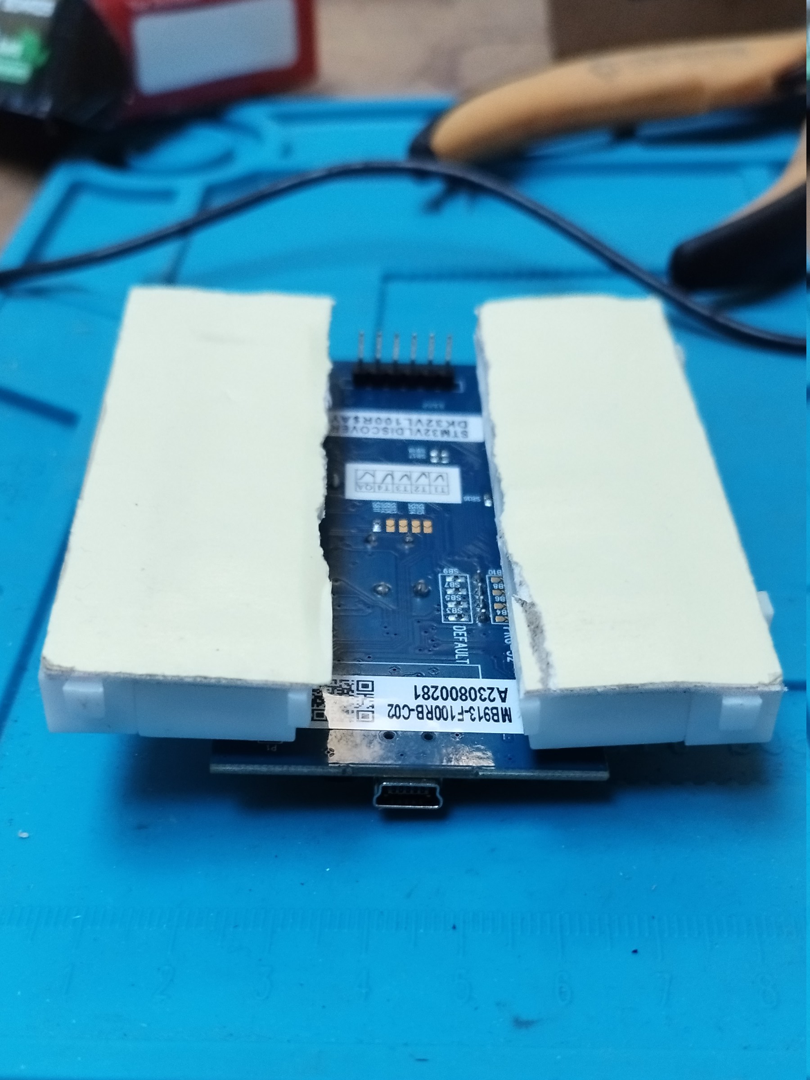
hardware/dev_boards/img/STM32-butterfly_mounting-03.jpg
