algorythmics/pianoplayer/hardware/escher/figures/escher1_bottom.png

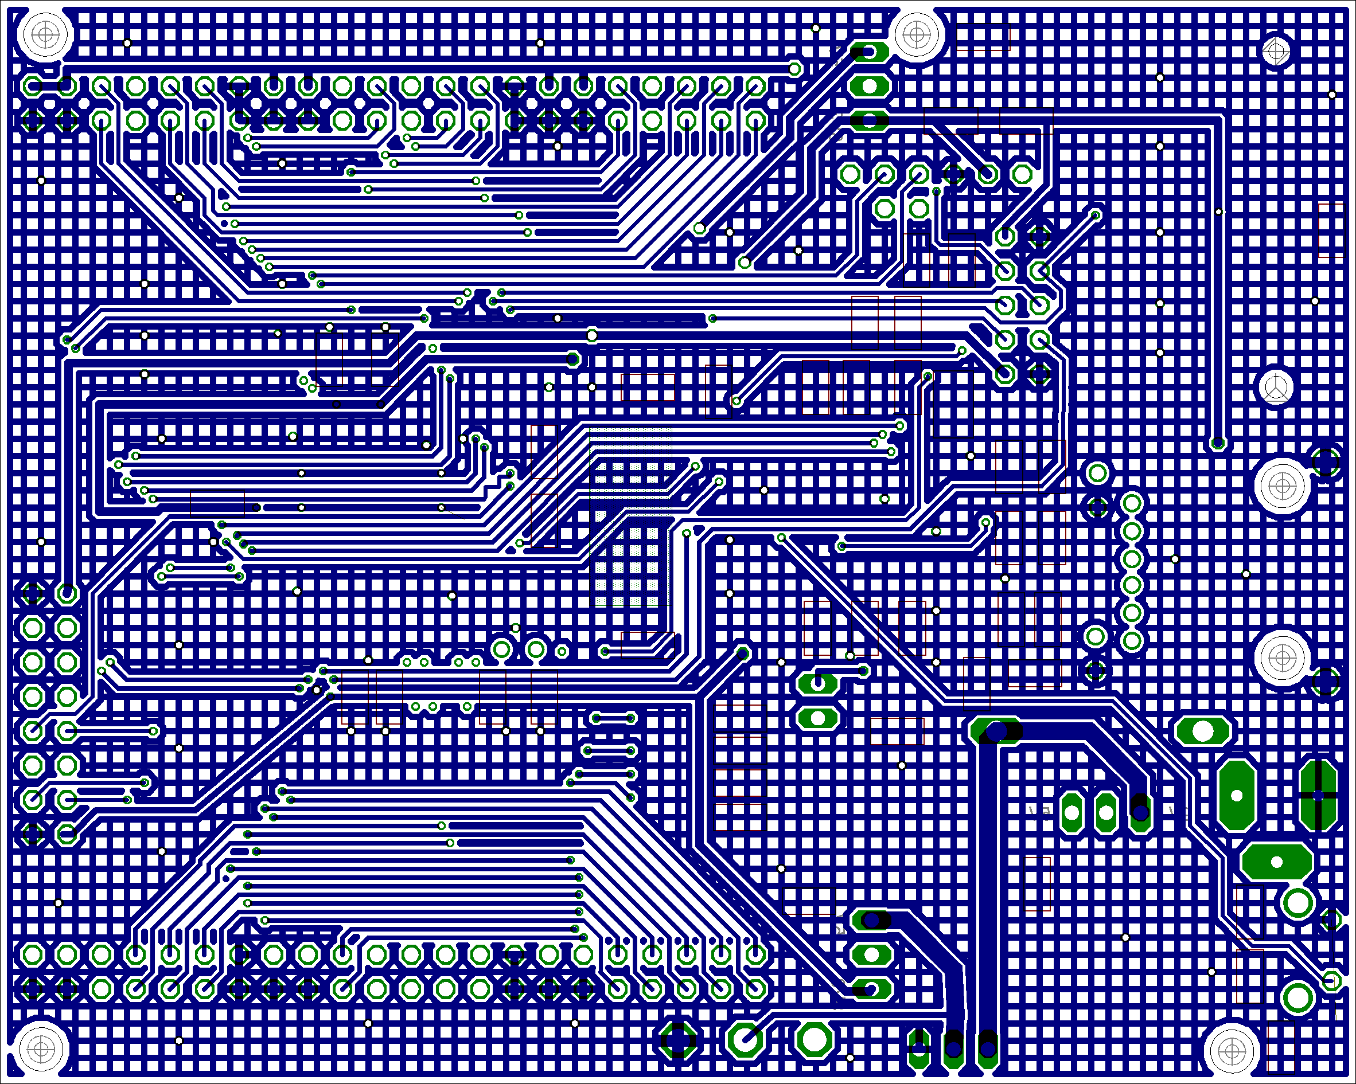
hardware/escher/figures/escher1_bottom.png
