algorythmics/pianoplayer/hardware/escher/figures/escher1_schematic1.png

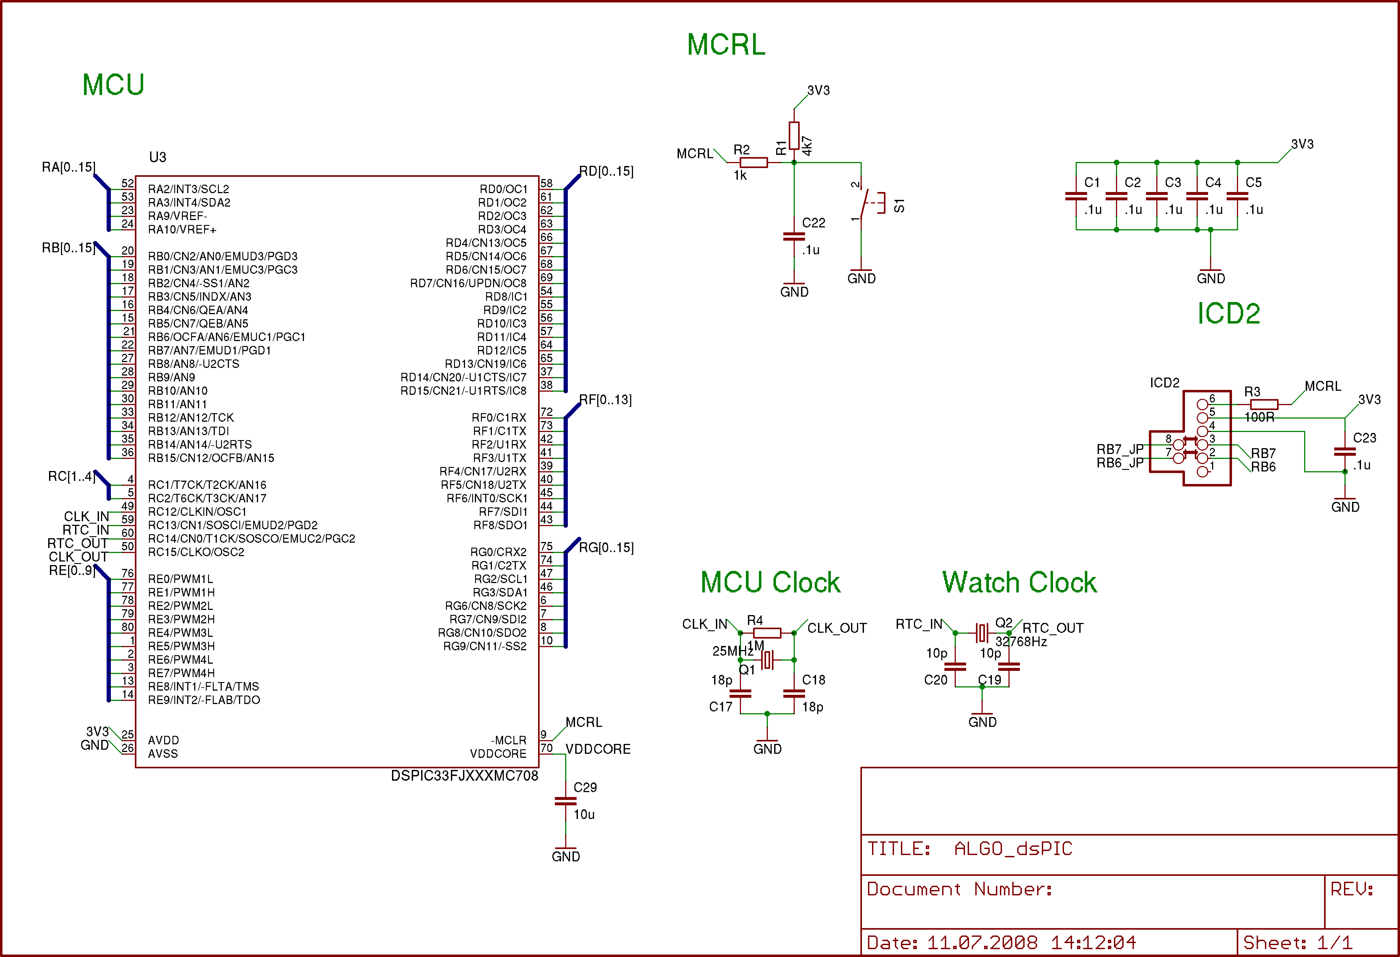
hardware/escher/figures/escher1_schematic1.png
