algorythmics/pianoplayer/hardware/escher/figures/escher1_schematic2.png

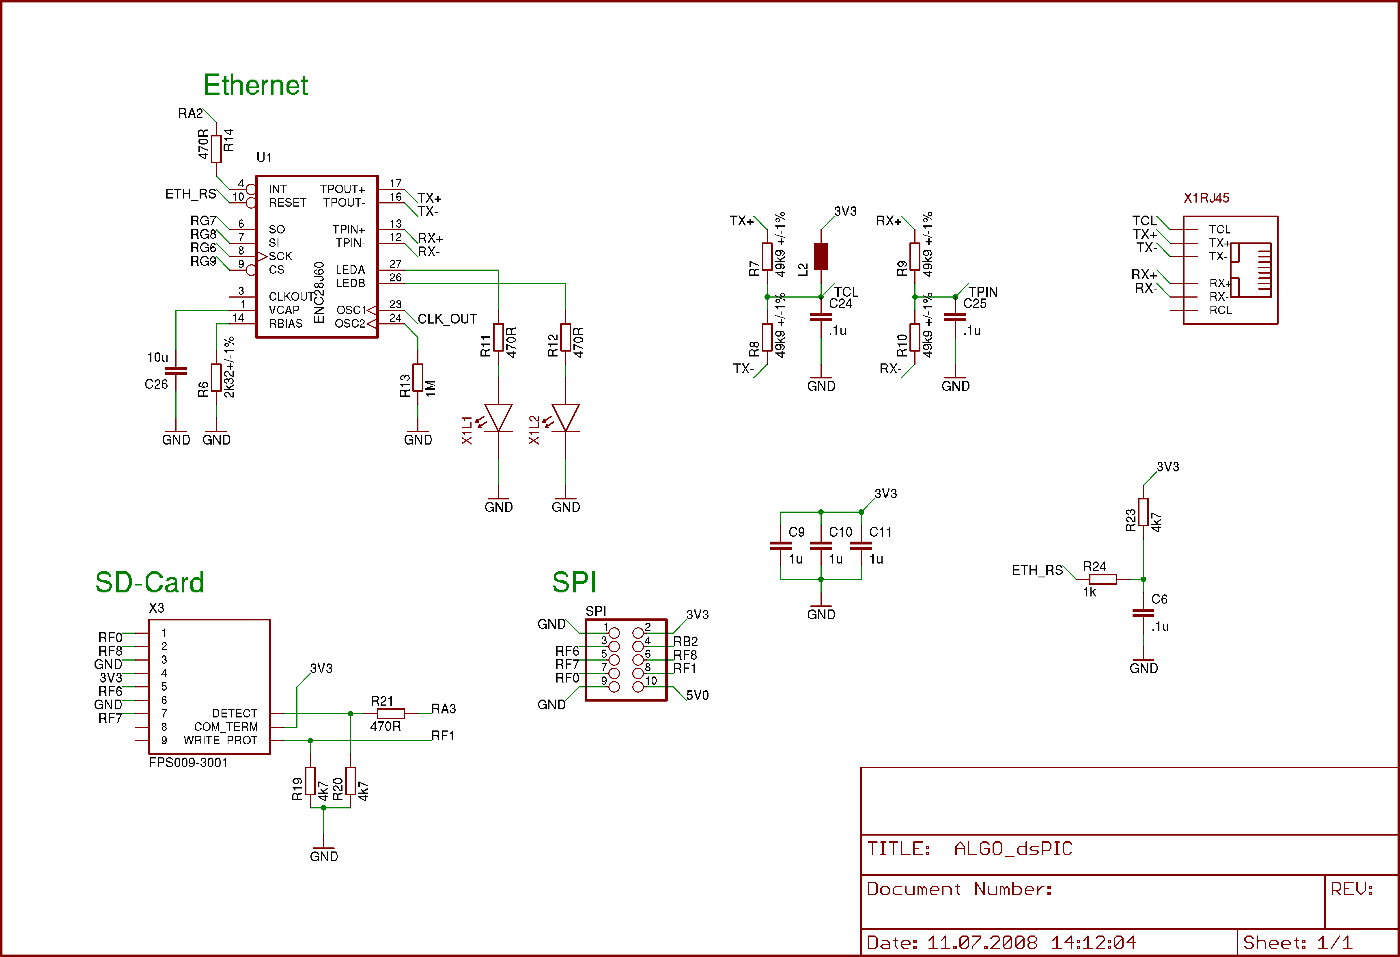
hardware/escher/figures/escher1_schematic2.png
