algorythmics/pianoplayer/hardware/escher/figures/escher1_schematic3.png

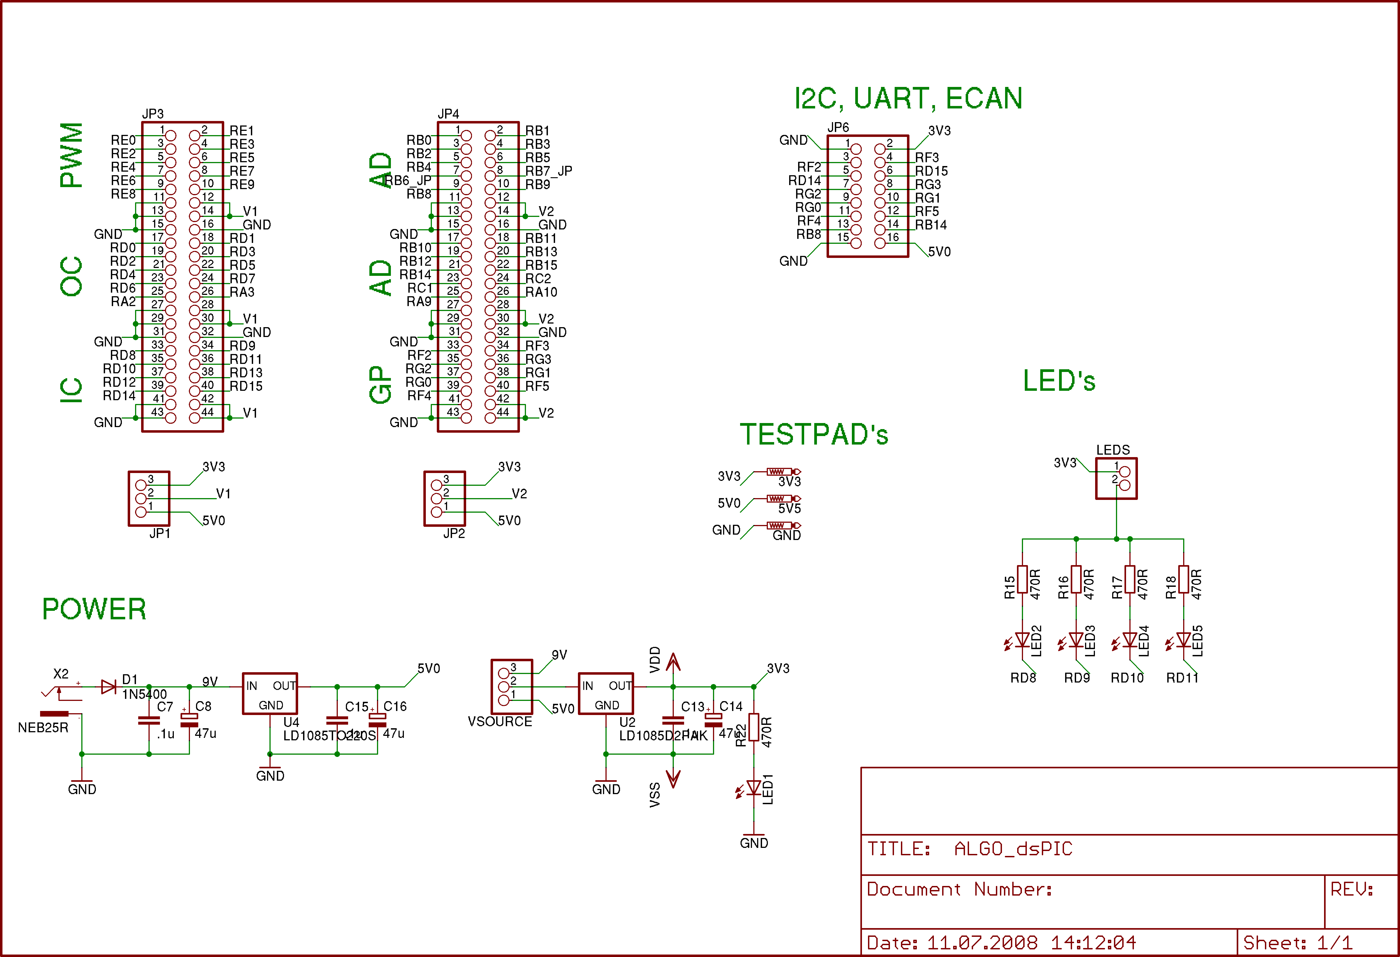
hardware/escher/figures/escher1_schematic3.png
