algorythmics/pianoplayer/hardware/escher/figures/escher1_top.png

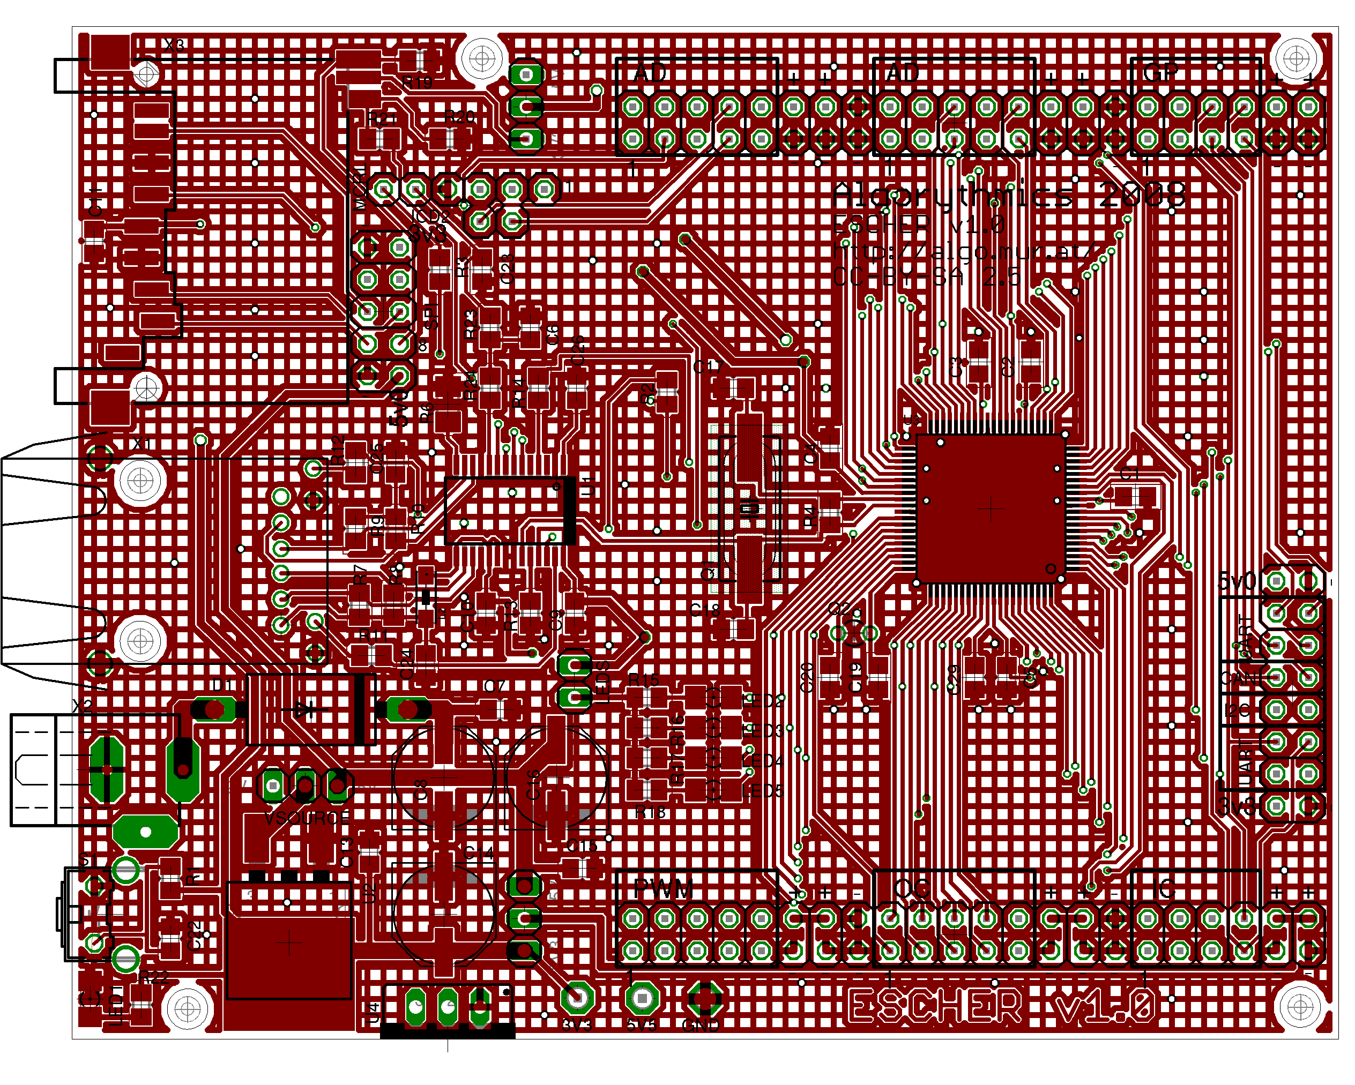
hardware/escher/figures/escher1_top.png
