algorythmics/pianoplayer/hardware/escher/images/escher1.jpg

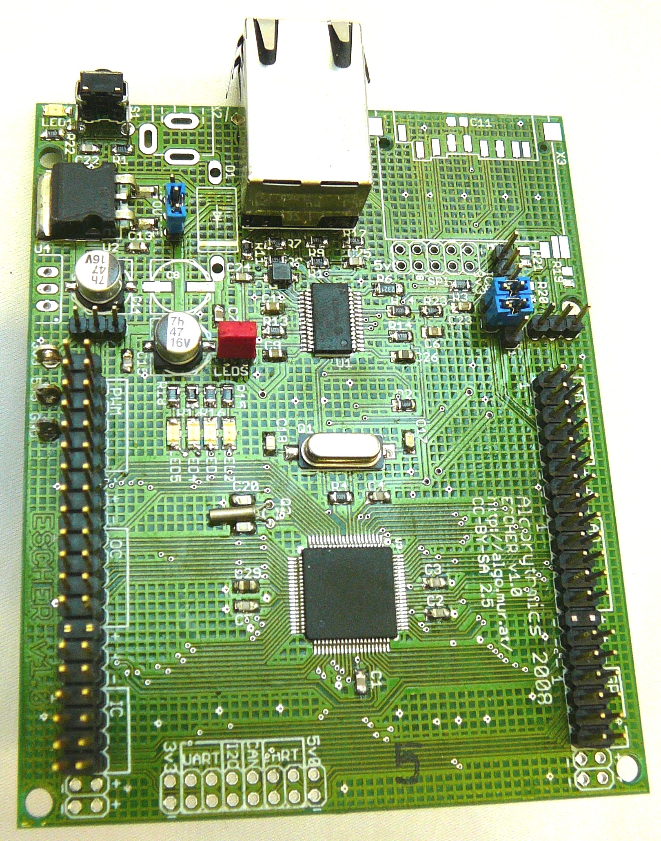
hardware/escher/images/escher1.jpg
