algorythmics/pianoplayer/hardware/escher/images/escher1_contour.png

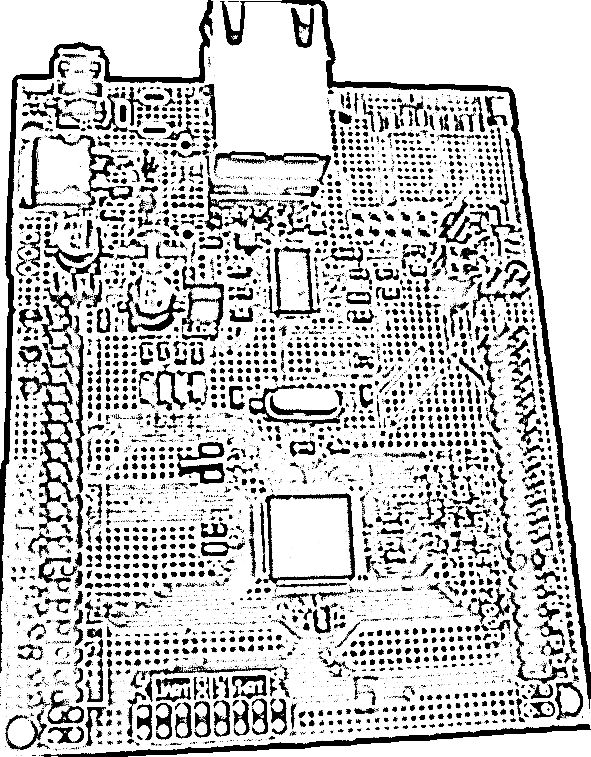
hardware/escher/images/escher1_contour.png
