algorythmics/pianoplayer/hardware/escher/images/escher1_flucht2.jpg

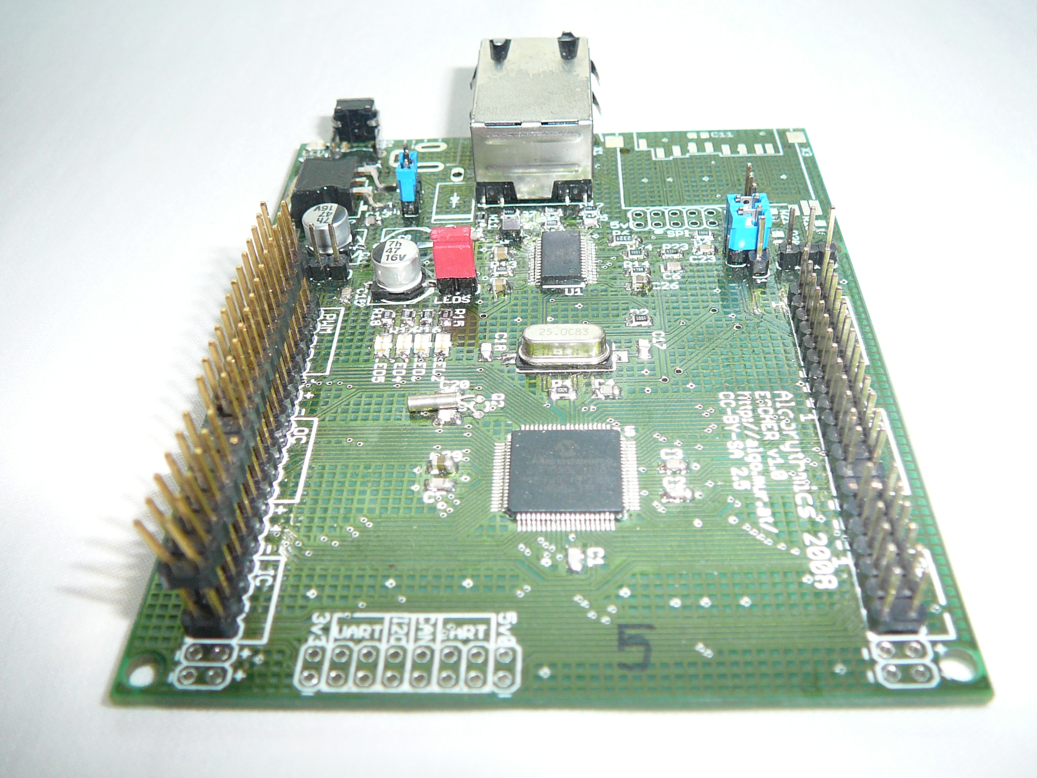
hardware/escher/images/escher1_flucht2.jpg
