algorythmics/pianoplayer/hardware/escher/images/escher1_flucht.jpg

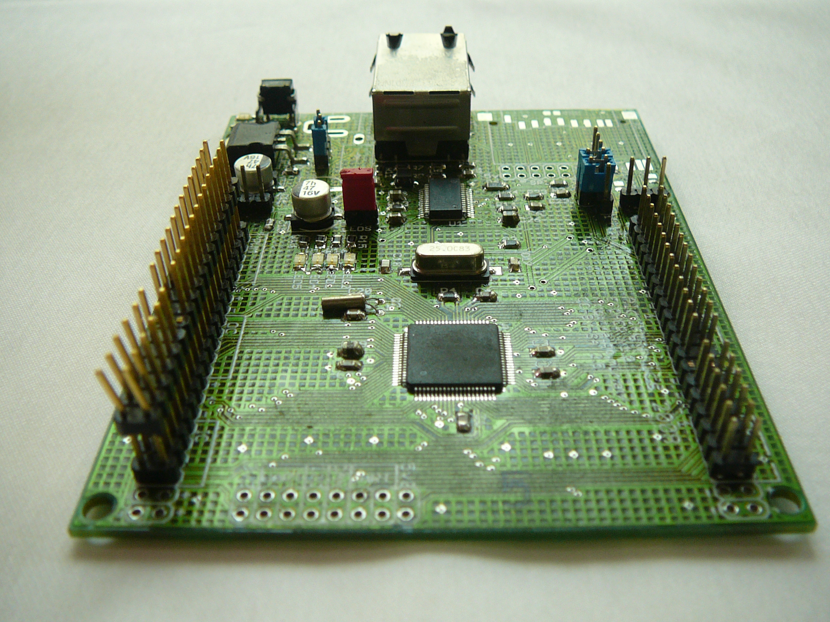
hardware/escher/images/escher1_flucht.jpg
