algorythmics/pianoplayer/hardware/escher/images/escher1_side.jpg

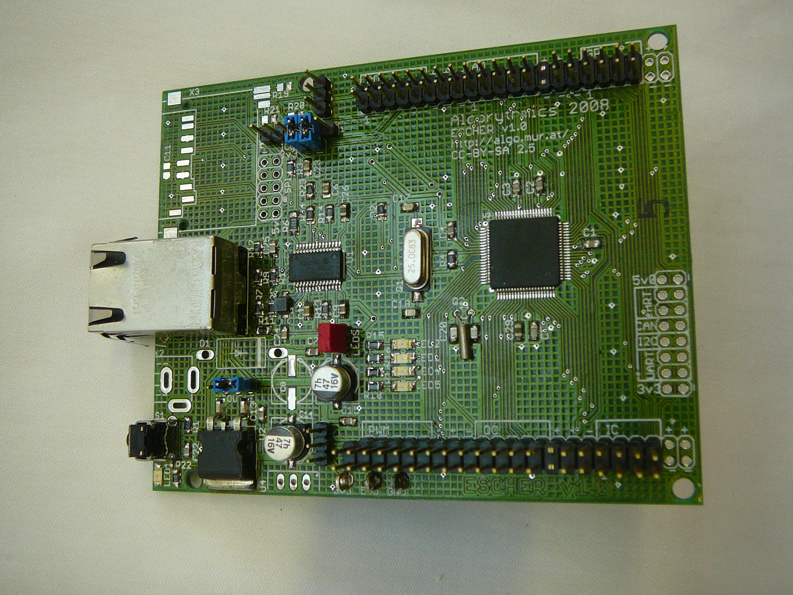
hardware/escher/images/escher1_side.jpg
