algorythmics/pianoplayer/hardware/escher/production/escher__drill_prototype.jpg

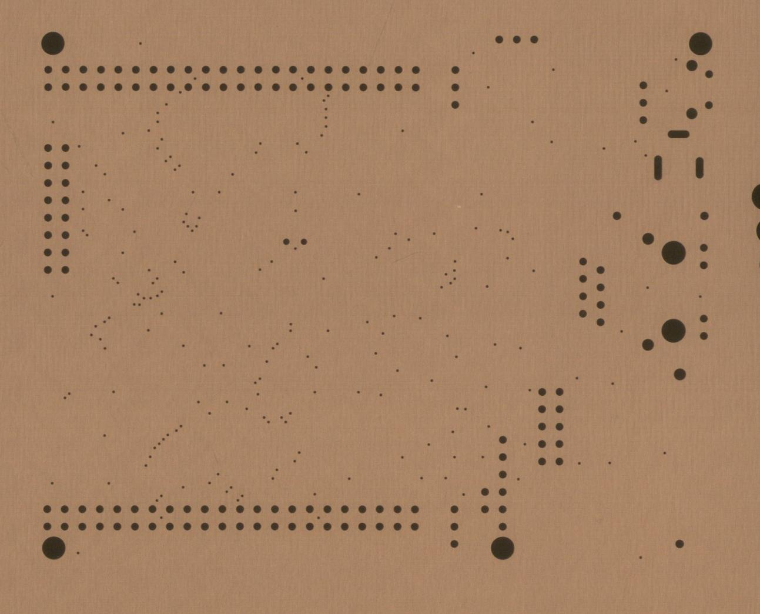
hardware/escher/production/escher__drill_prototype.jpg
