algorythmics/pianoplayer/hardware/escher/production/escher__hotair_prototype.jpg

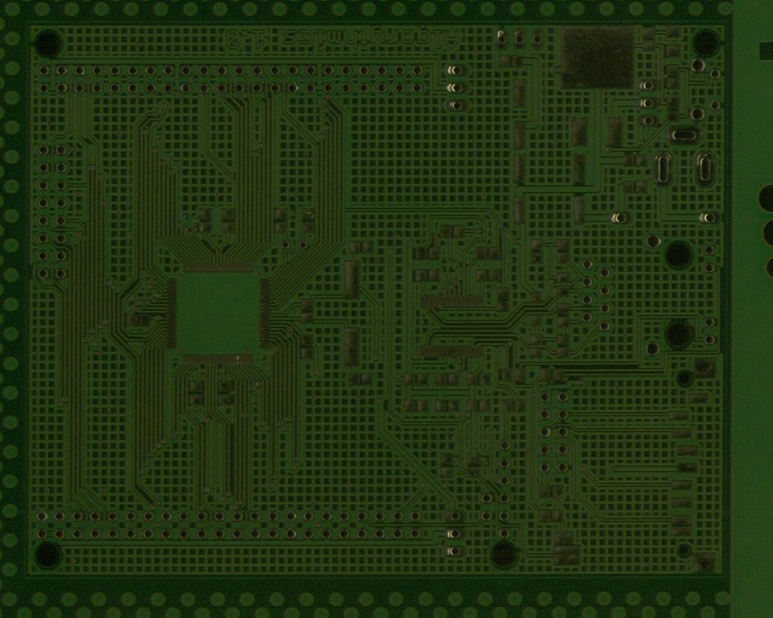
hardware/escher/production/escher__hotair_prototype.jpg
