algorythmics/pianoplayer/hardware/escher/production/escher_board_prototype.jpg

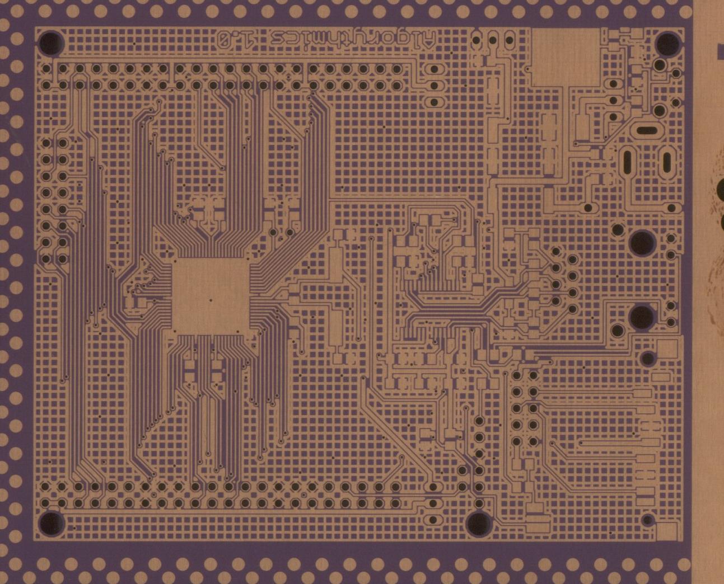
hardware/escher/production/escher_board_prototype.jpg
