algorythmics/pianoplayer/hardware/escher/production/escher_drill.jpg

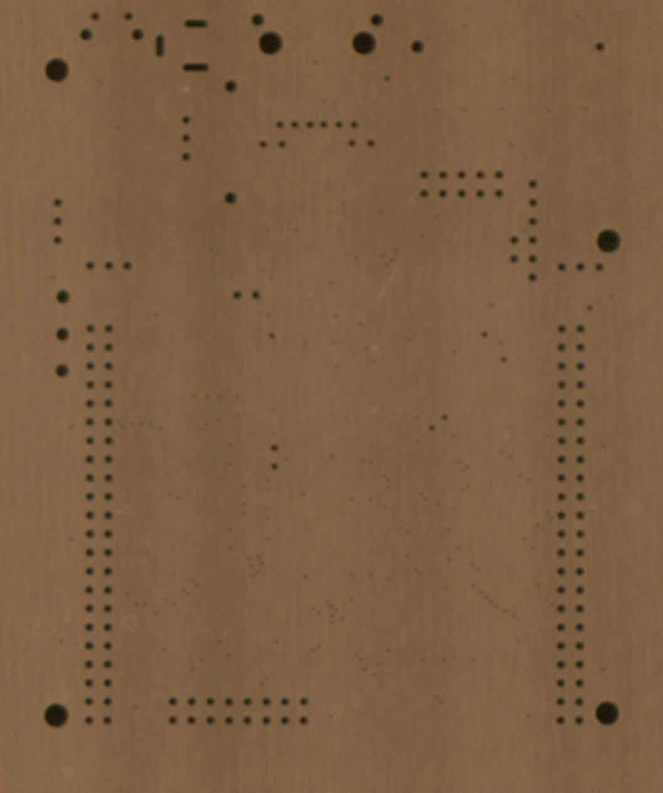
hardware/escher/production/escher_drill.jpg
