algorythmics/pianoplayer/hardware/escher/production/escher_dry.jpg

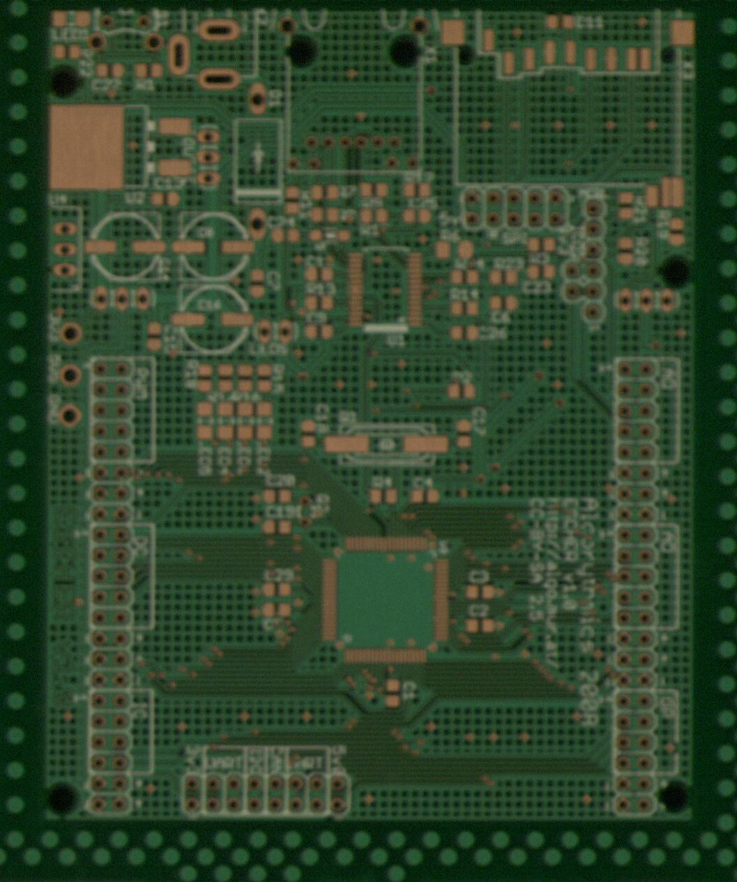
hardware/escher/production/escher_dry.jpg
