algorythmics/pianoplayer/hardware/escher/production/escher_hotair.jpg

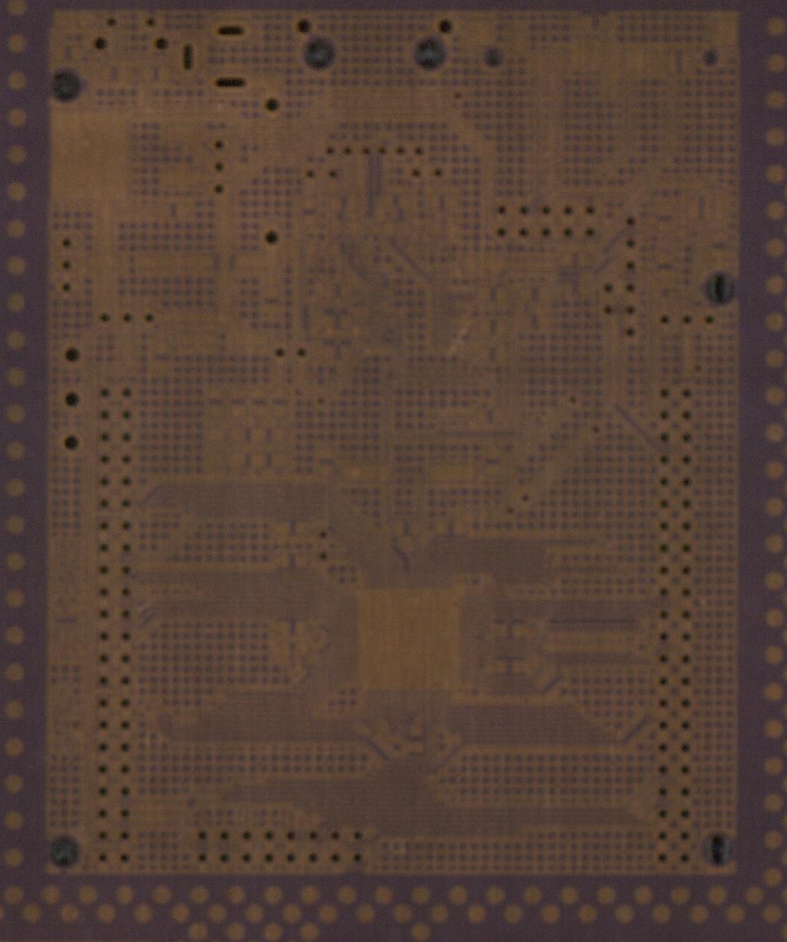
hardware/escher/production/escher_hotair.jpg
