algorythmics/pianoplayer/hardware/escher/production/escher_lack.jpg

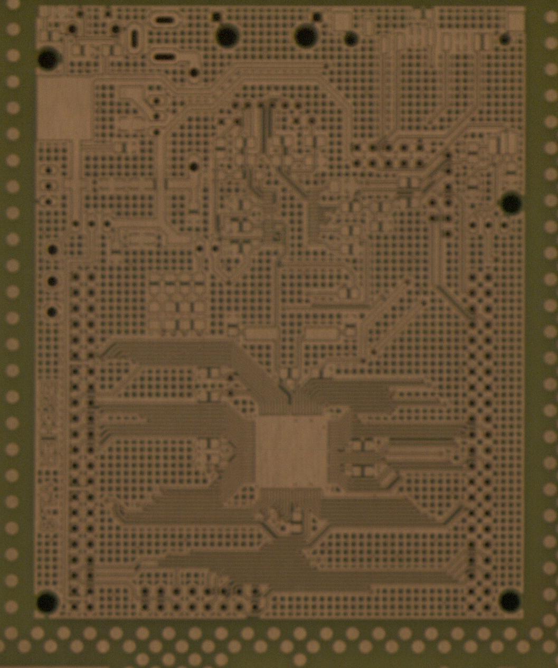
hardware/escher/production/escher_lack.jpg
