algorythmics/pianoplayer/hardware/escher/production/escher_uv_prototype.jpg

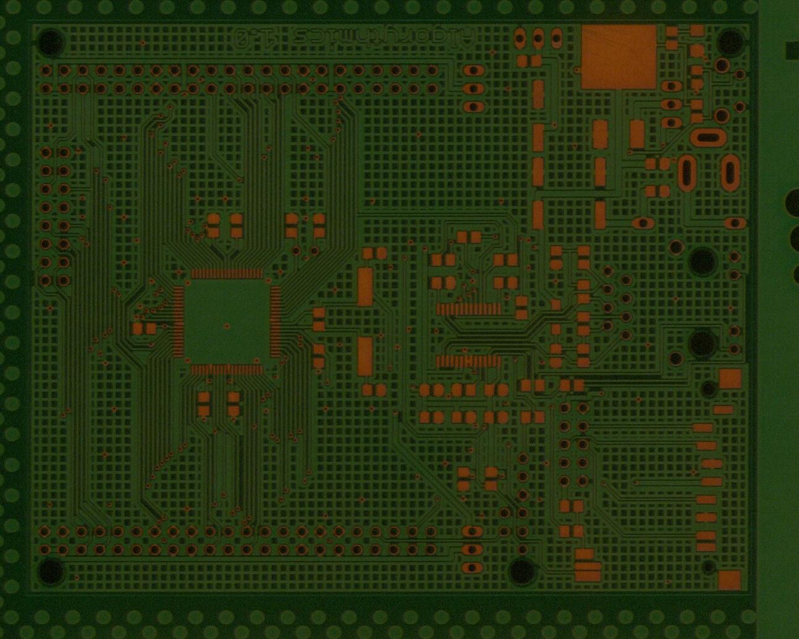
hardware/escher/production/escher_uv_prototype.jpg
