algorythmics/pianoplayer/hardware/escherFET16/figures/fet16_bottom.png

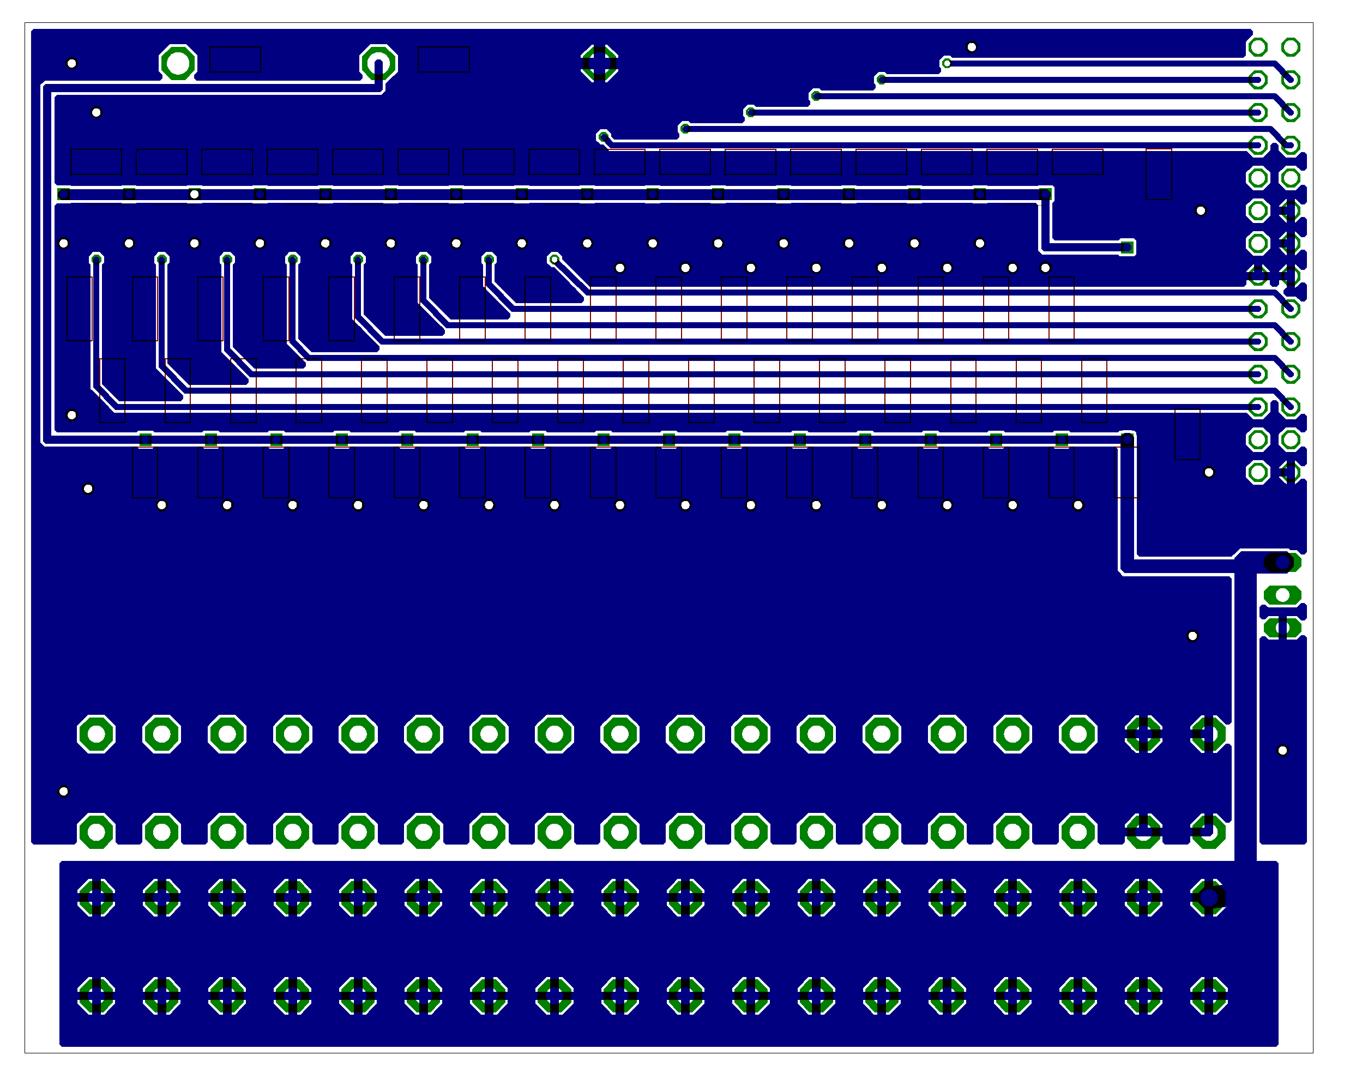
hardware/escherFET16/figures/fet16_bottom.png
