algorythmics/pianoplayer/hardware/escherFET16/figures/fet16_production_pcbpool.jpg

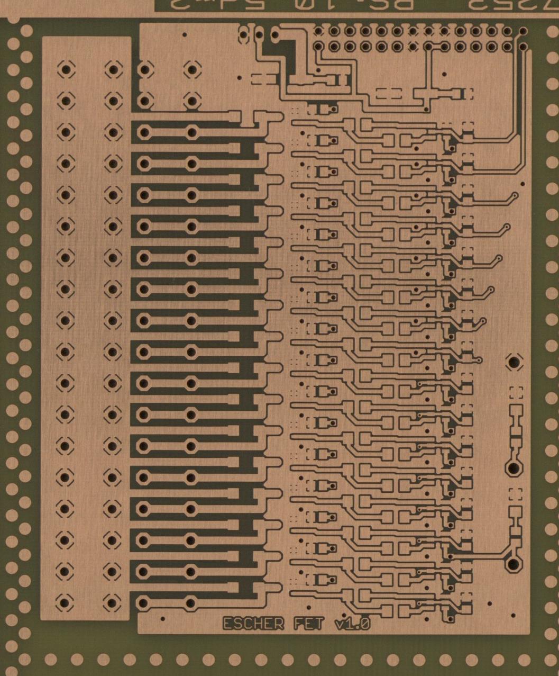
hardware/escherFET16/figures/fet16_production_pcbpool.jpg
