algorythmics/pianoplayer/hardware/escherFET16/figures/fet16_schematic1.png

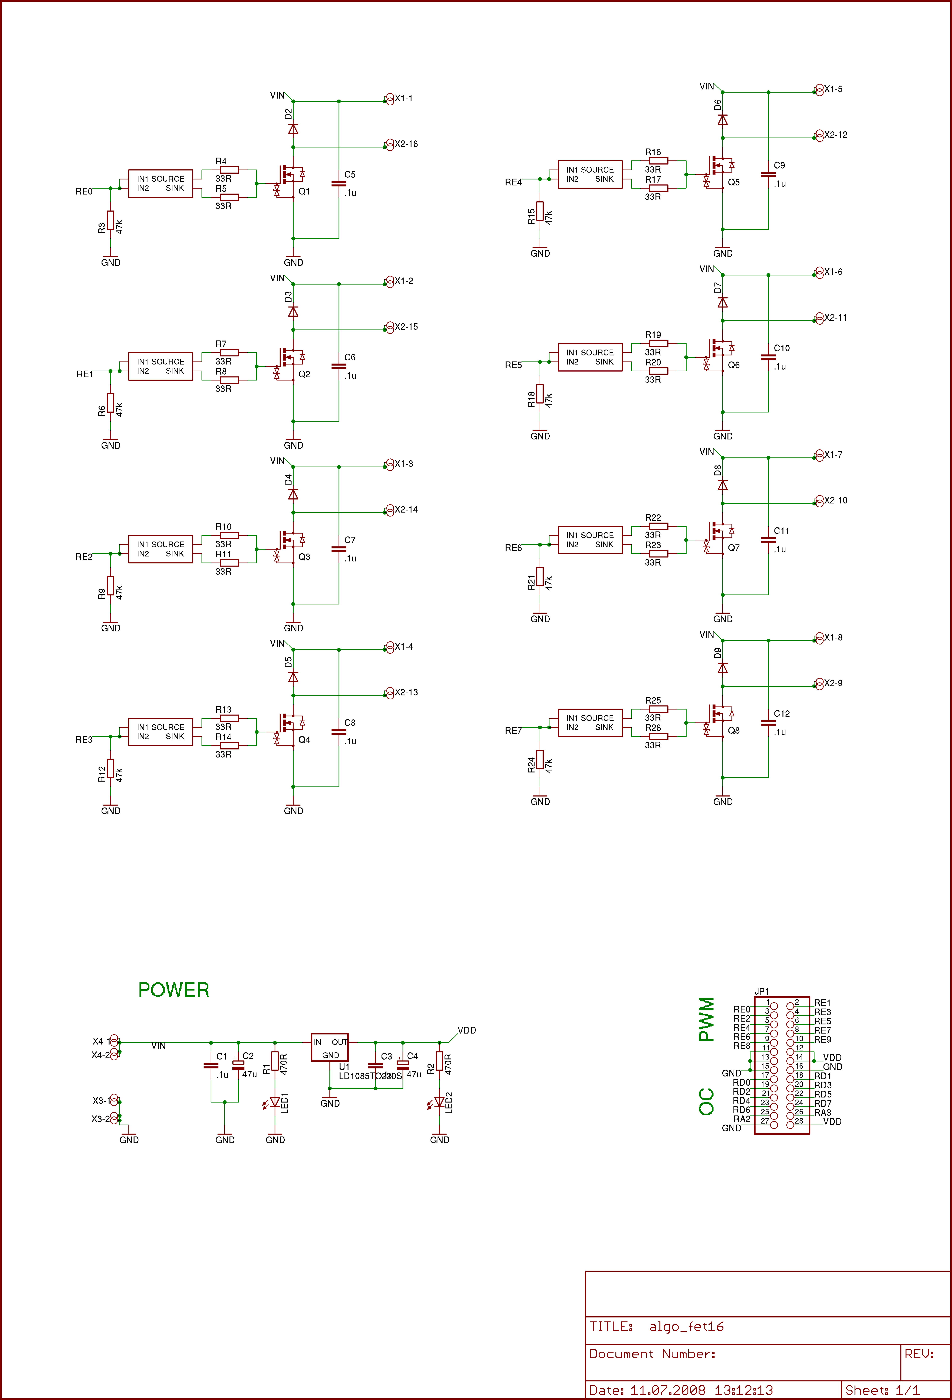
hardware/escherFET16/figures/fet16_schematic1.png
