algorythmics/pianoplayer/hardware/escherFET16/figures/fet16_schematic2.png

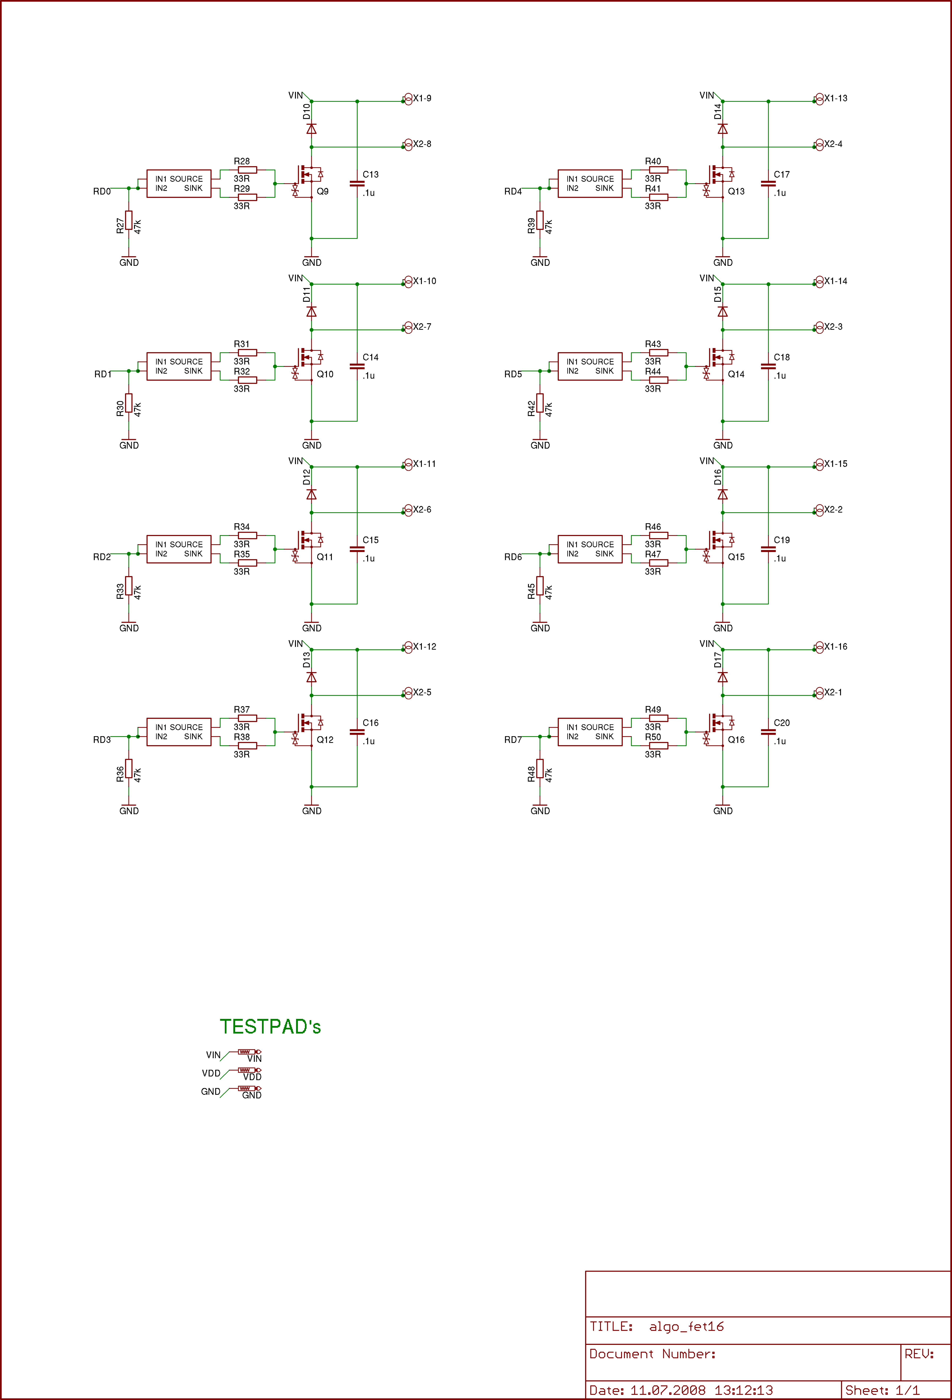
hardware/escherFET16/figures/fet16_schematic2.png
