algorythmics/pianoplayer/hardware/escherFET16/figures/fet16_top.png

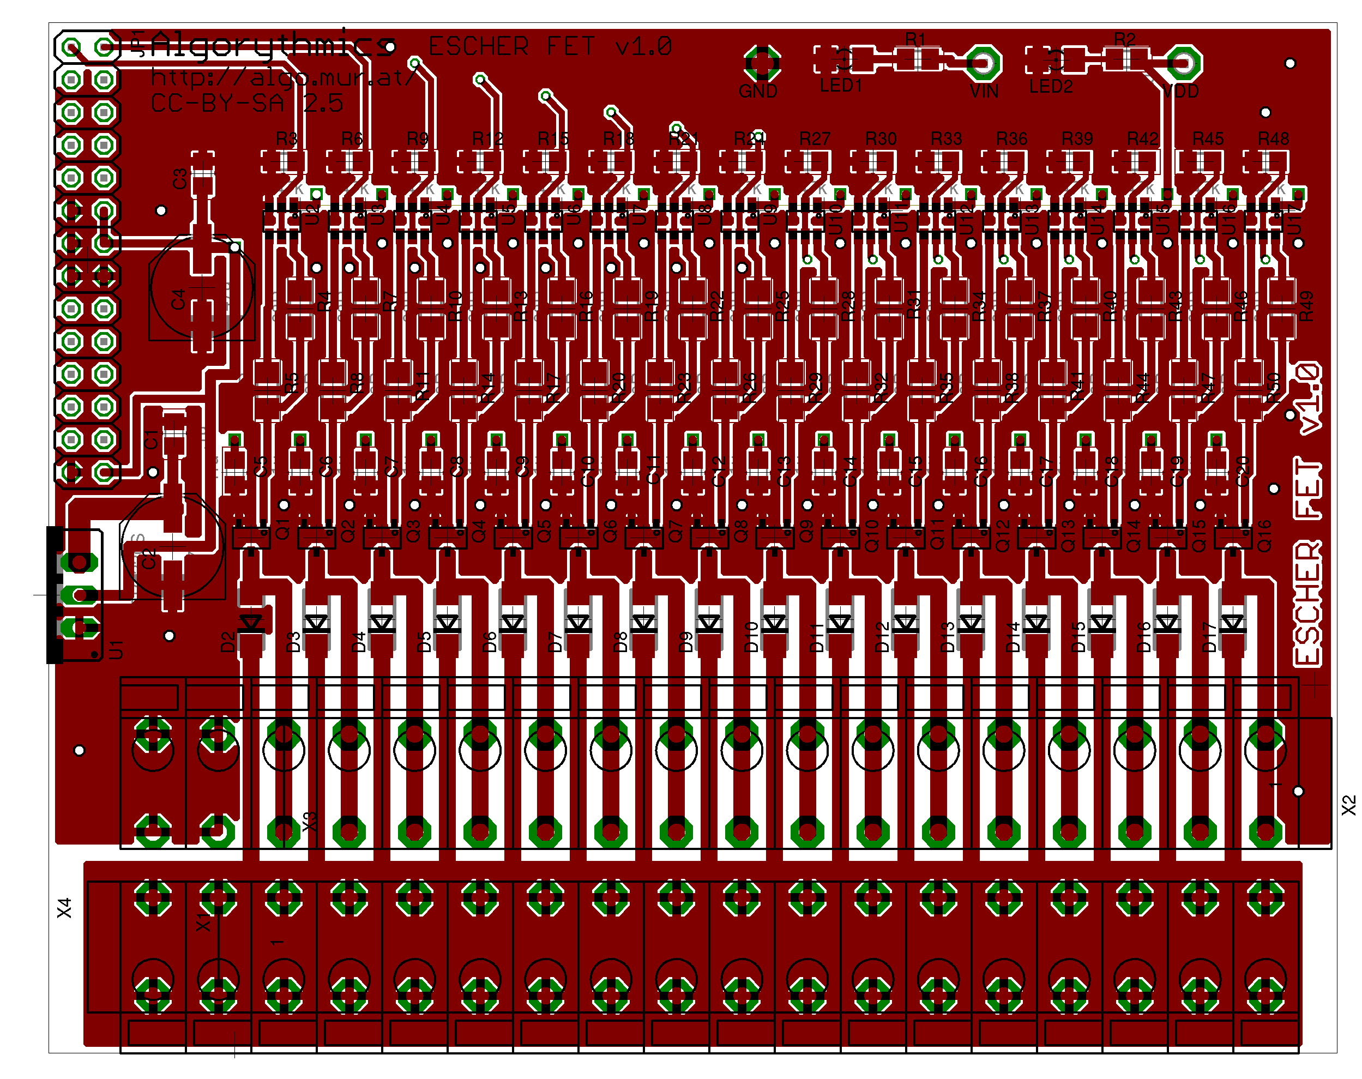
hardware/escherFET16/figures/fet16_top.png
