algorythmics/pianoplayer/hardware/escherFET16/images/escher_fet.jpg

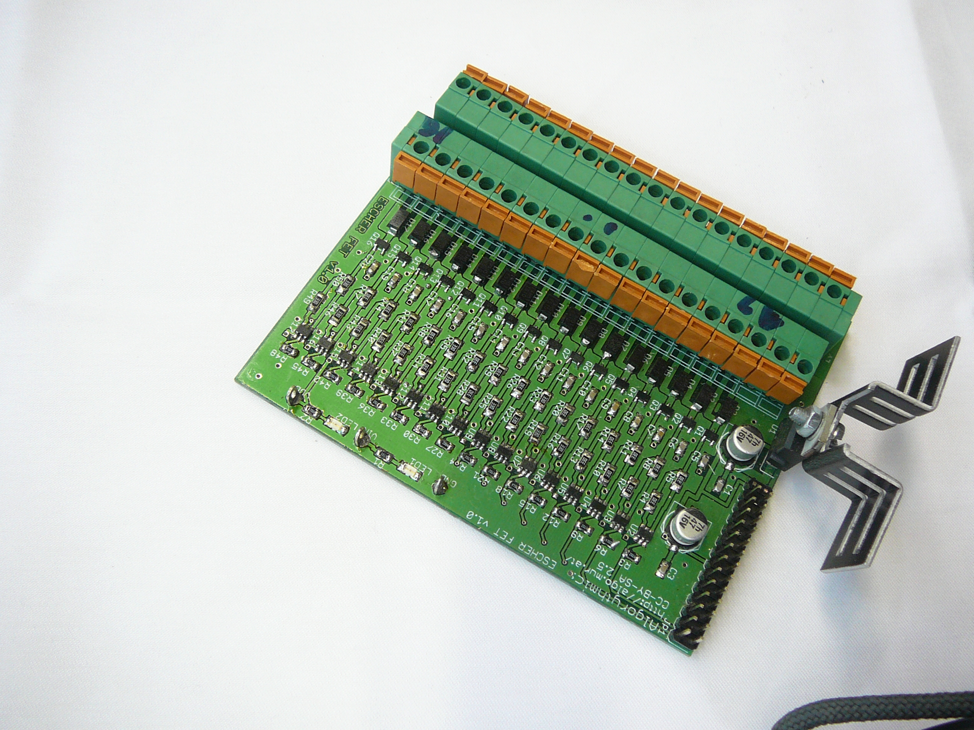
hardware/escherFET16/images/escher_fet.jpg
