algorythmics/pianoplayer/hardware/escherFET16/images/escher_fet_bottom.jpg

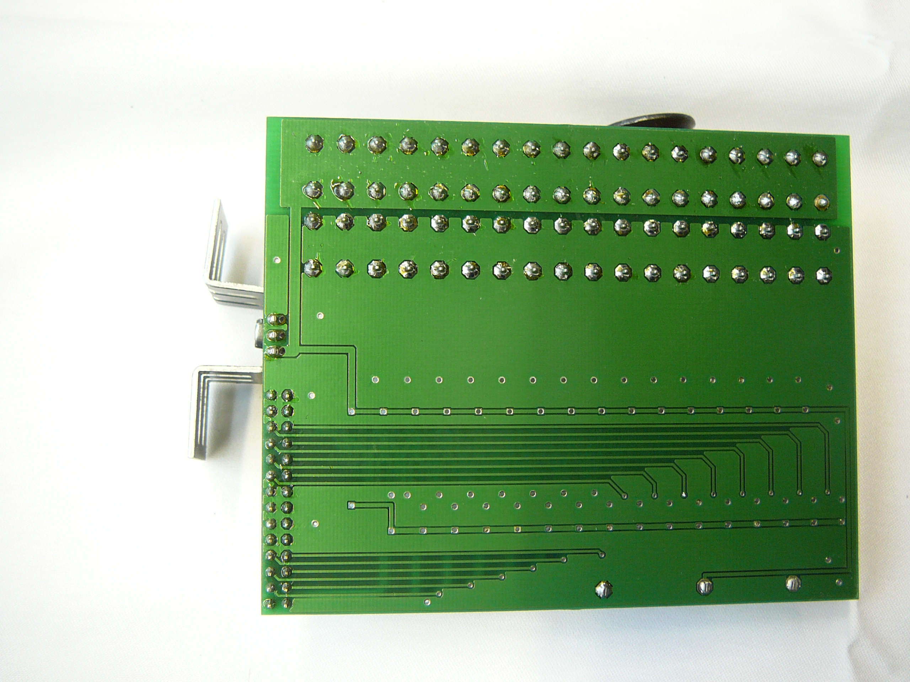
hardware/escherFET16/images/escher_fet_bottom.jpg
