algorythmics/pianoplayer/hardware/escherFET16/images/escher_fet_top2.jpg

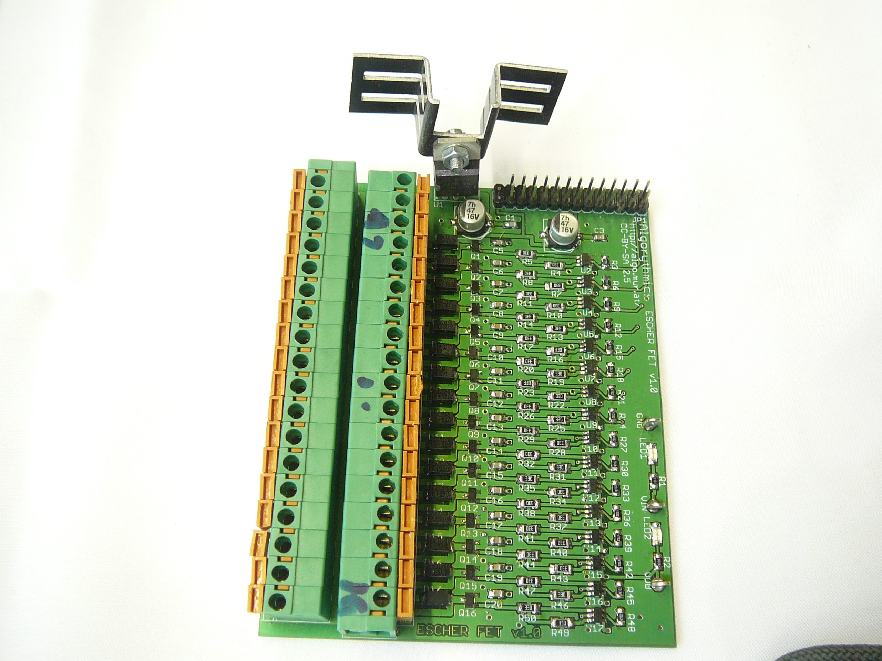
hardware/escherFET16/images/escher_fet_top2.jpg
