algorythmics/pianoplayer/hardware/federn/20180902-kegelstumpffeder-automatenklavier.jpg

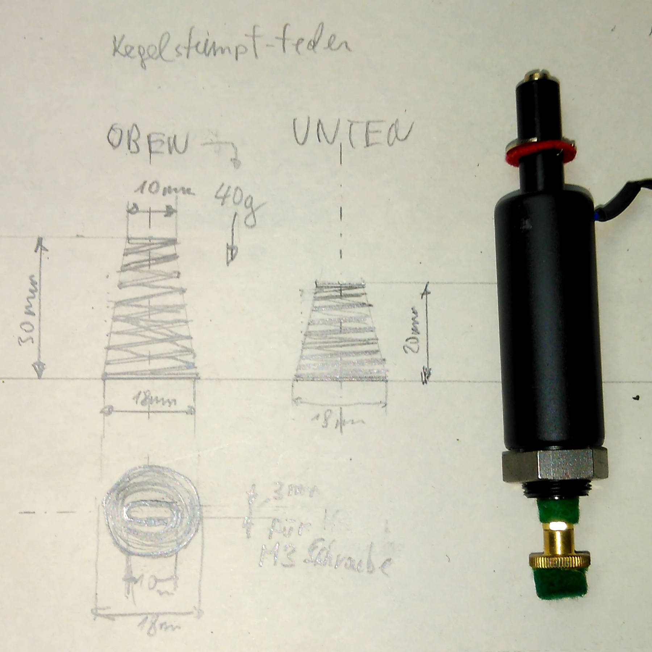
hardware/federn/20180902-kegelstumpffeder-automatenklavier.jpg
