algorythmics/pianoplayer/hardware/federn/20181016-kegelstumpffeder-beschriftet.jpg

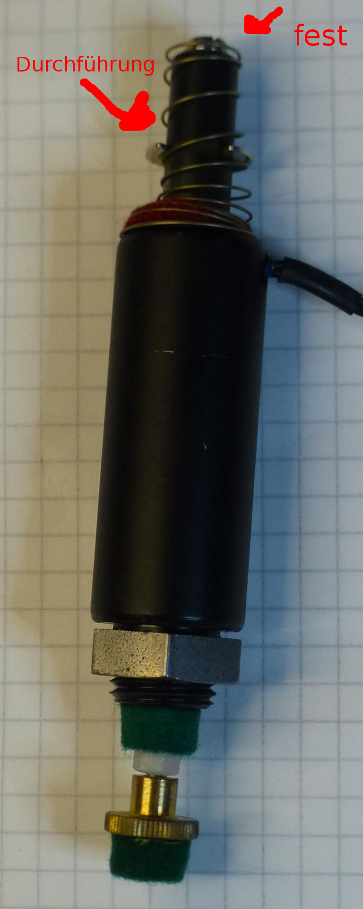
hardware/federn/20181016-kegelstumpffeder-beschriftet.jpg
