algorythmics/pianoplayer/hardware/federn/20181016-oneKeyPianoPlayer-01_smaller.jpg

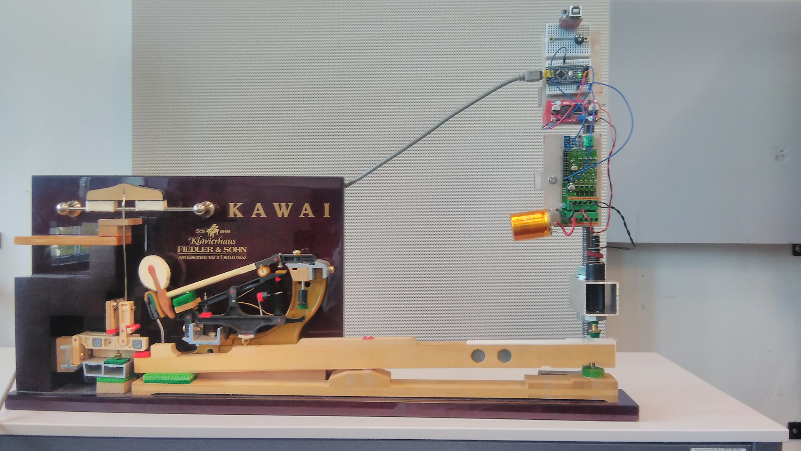
hardware/federn/20181016-oneKeyPianoPlayer-01_smaller.jpg
