algorythmics/pianoplayer/hardware/federn/feder_bussmann.jpg

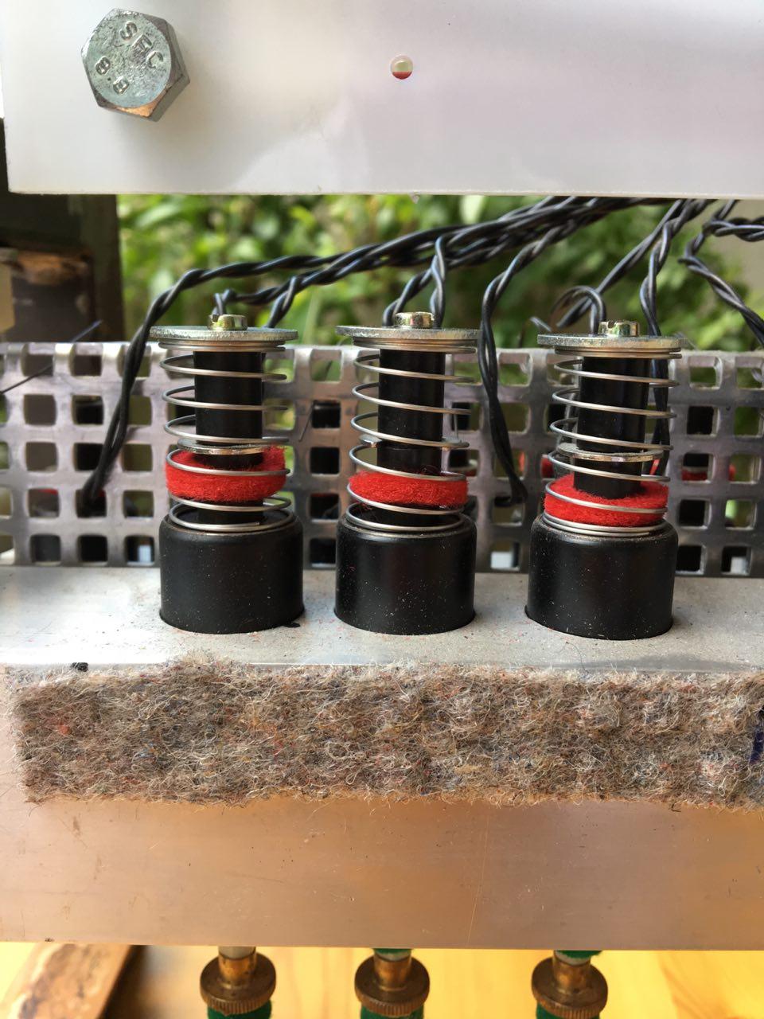
hardware/federn/feder_bussmann.jpg
