algorythmics/pianoplayer/hardware/federn/federn-blackknights_solenoids.jpg

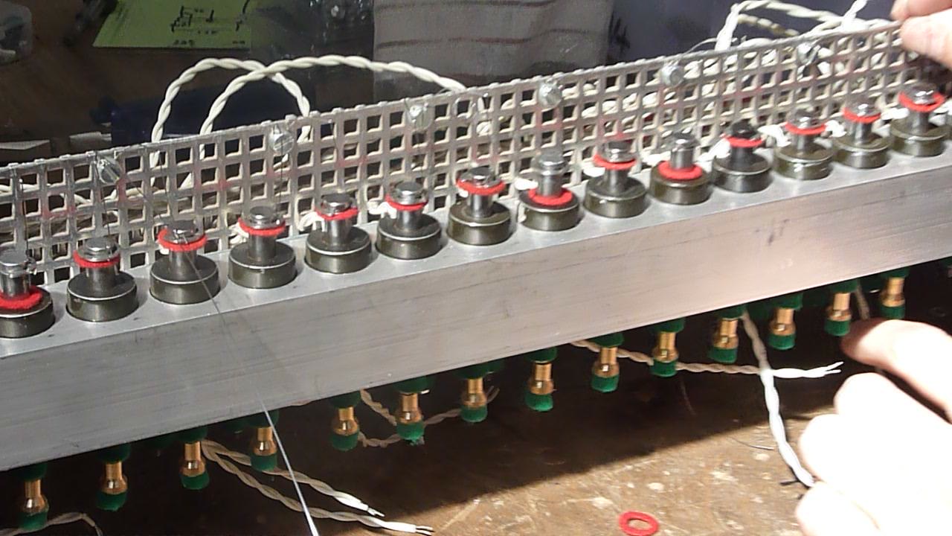
hardware/federn/federn-blackknights_solenoids.jpg
