algorythmics/pianoplayer/hardware/federn/federn_ausschnitt-blackknights_solenoids.jpg

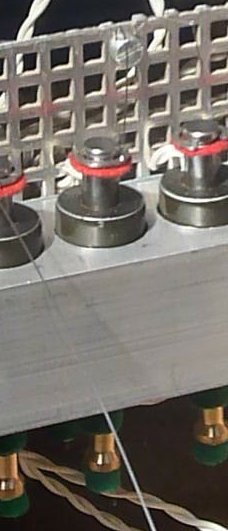
hardware/federn/federn_ausschnitt-blackknights_solenoids.jpg
