algorythmics/pianoplayer/hardware/federn/formfeder_neu_rhea-V2.jpg

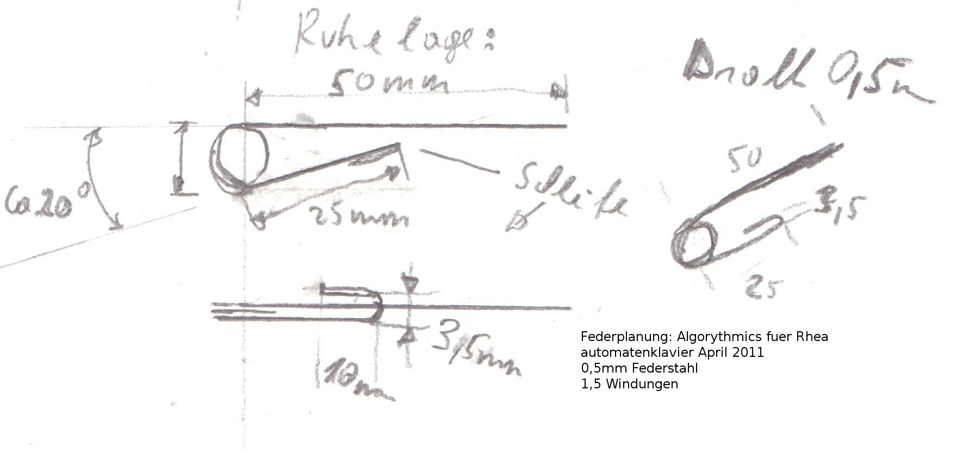
hardware/federn/formfeder_neu_rhea-V2.jpg
