algorythmics/pianoplayer/hardware/federn/formfeder_skizze_alt.jpg

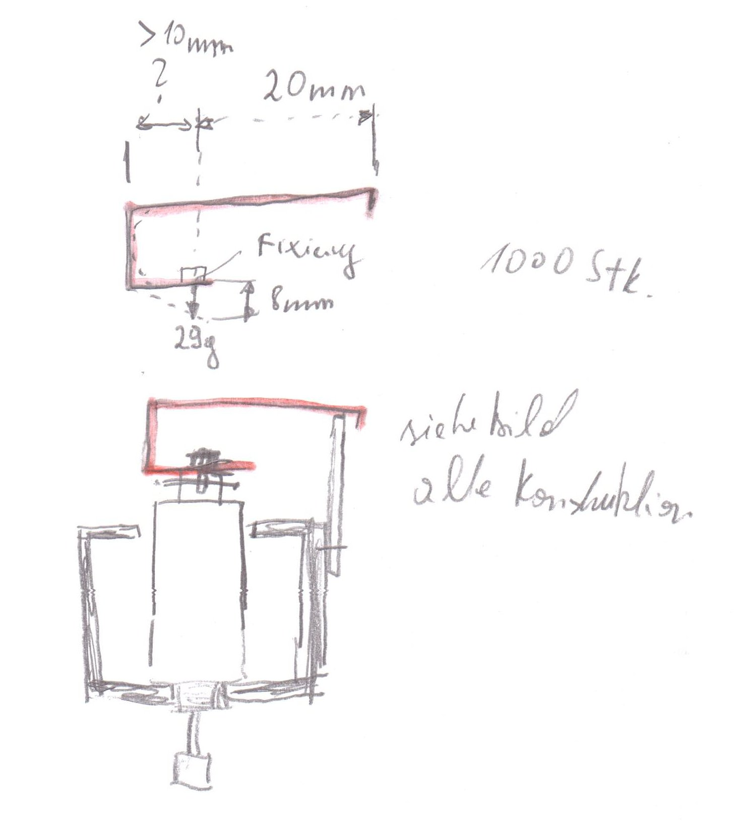
hardware/federn/formfeder_skizze_alt.jpg
