algorythmics/pianoplayer/hardware/solenoids/AO2051.jpg

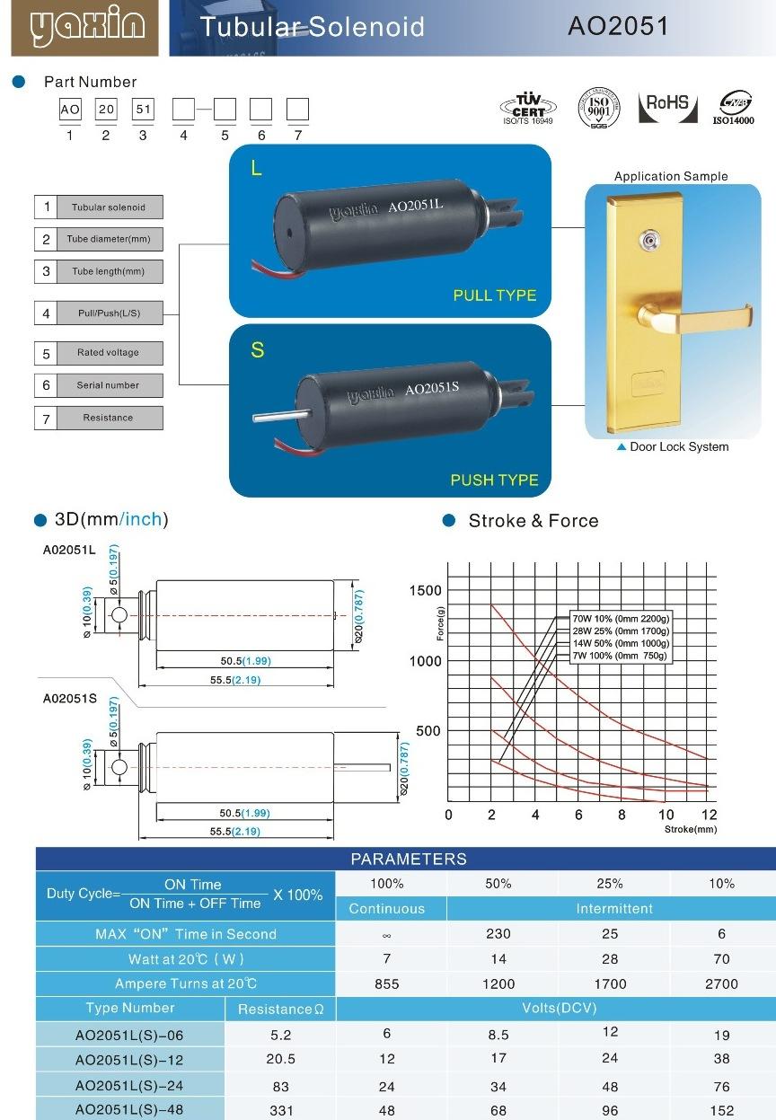
hardware/solenoids/AO2051.jpg
