algorythmics/pianoplayer/hardware/solenoids/AO2051S_new2_cut.png

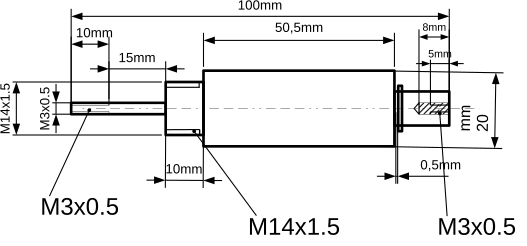
hardware/solenoids/AO2051S_new2_cut.png
