algorythmics/pianoplayer/hardware/escher/figures/escher1_parts.png

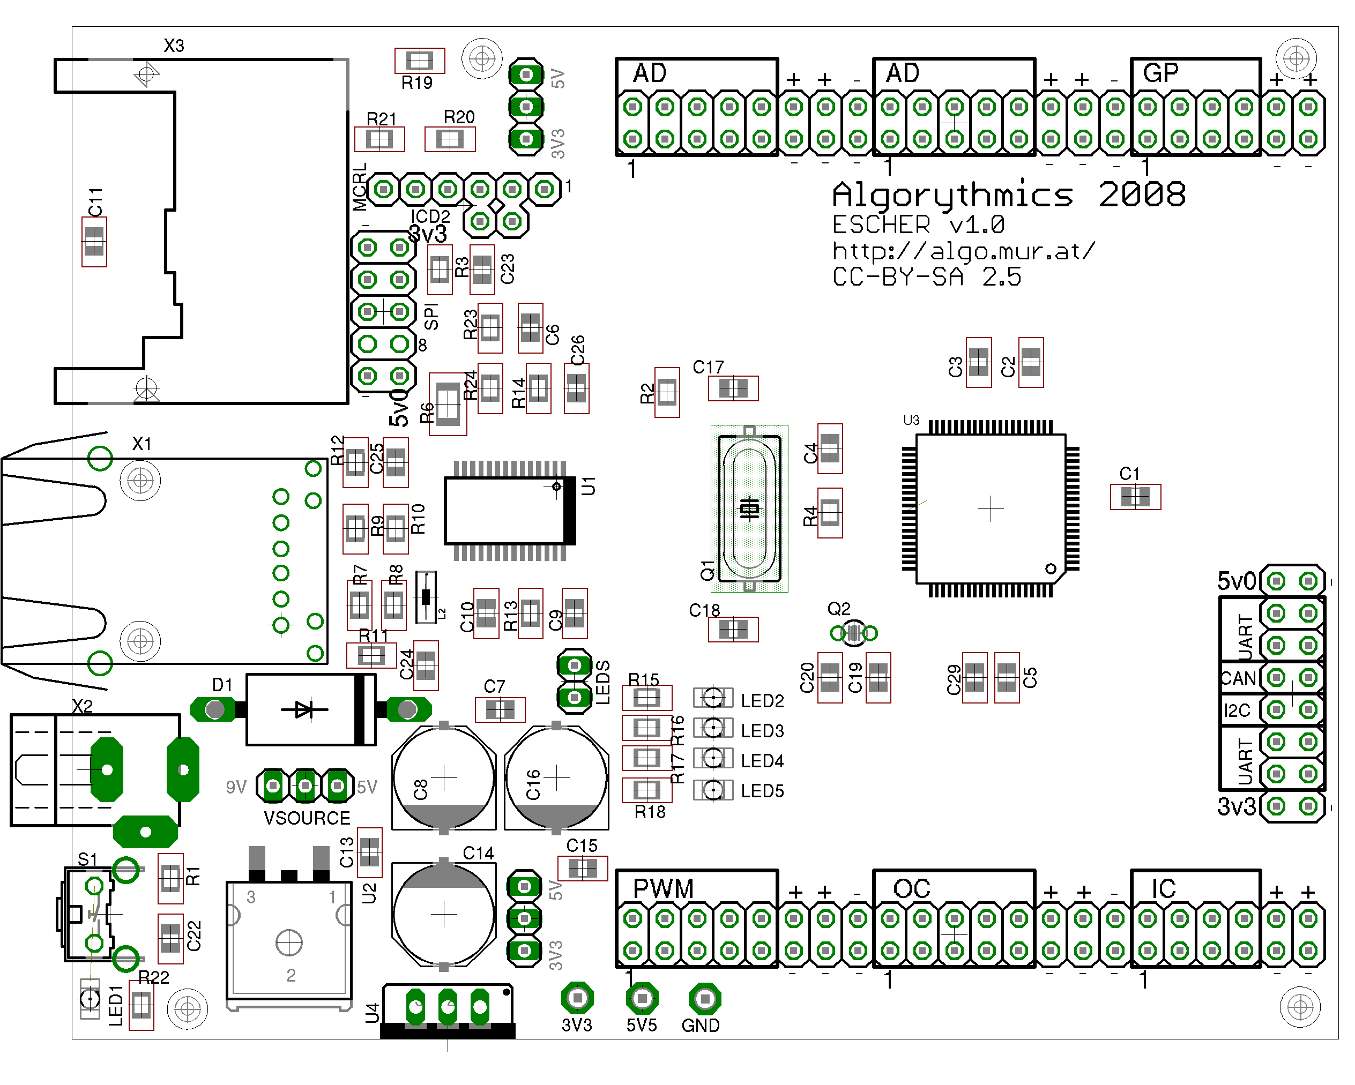
hardware/escher/figures/escher1_parts.png
