algorythmics/pianoplayer/doku/rhea_3rd_generation/montage_rhea/01a-aklavier_abschrauben-links.jpg

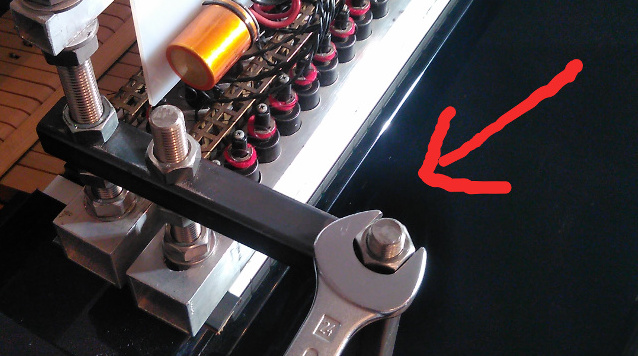
doku/rhea_3rd_generation/montage_rhea/01a-aklavier_abschrauben-links.jpg
