algorythmics/pianoplayer/doku/rhea_3rd_generation/montage_rhea/01b-aklavier_abschrauben-rechts.jpg

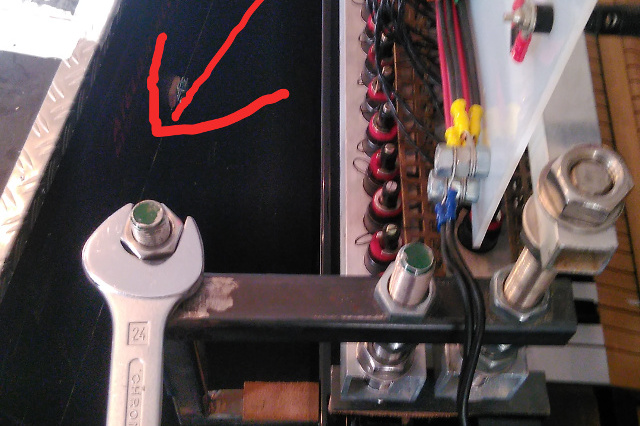
doku/rhea_3rd_generation/montage_rhea/01b-aklavier_abschrauben-rechts.jpg
