algorythmics/pianoplayer/doku/rhea_3rd_generation/montage_rhea/02a-aklavier_kabelabschrauben.jpg

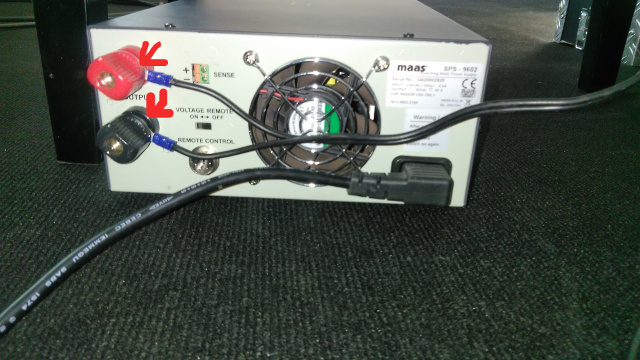
doku/rhea_3rd_generation/montage_rhea/02a-aklavier_kabelabschrauben.jpg
