algorythmics/pianoplayer/doku/rhea_3rd_generation/montage_rhea/02b-aklavier_kabel-ausstecken.jpg

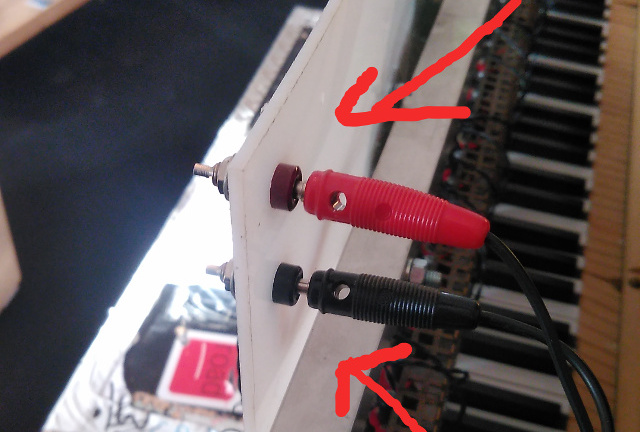
doku/rhea_3rd_generation/montage_rhea/02b-aklavier_kabel-ausstecken.jpg
