algorythmics/pianoplayer/doku/rhea_3rd_generation/montage_rhea/03a-aklavier_schraube-rechts.jpg

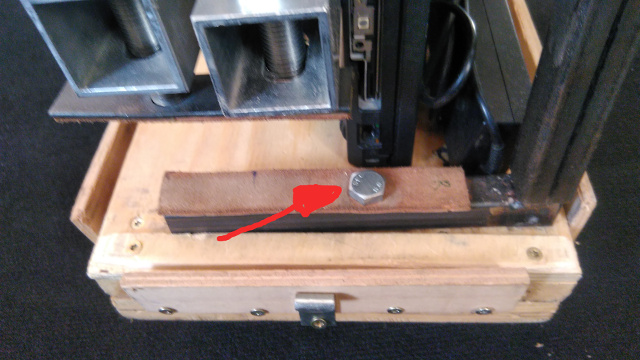
doku/rhea_3rd_generation/montage_rhea/03a-aklavier_schraube-rechts.jpg
