algorythmics/pianoplayer/doku/rhea_3rd_generation/montage_rhea/03b-aklavier_schraube-links.jpg

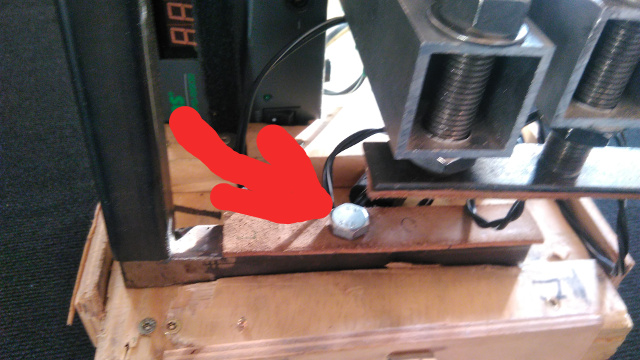
doku/rhea_3rd_generation/montage_rhea/03b-aklavier_schraube-links.jpg
