algorythmics/pianoplayer/doku/rhea_3rd_generation/montage_rhea/04-aklavier_verbpackt.jpg

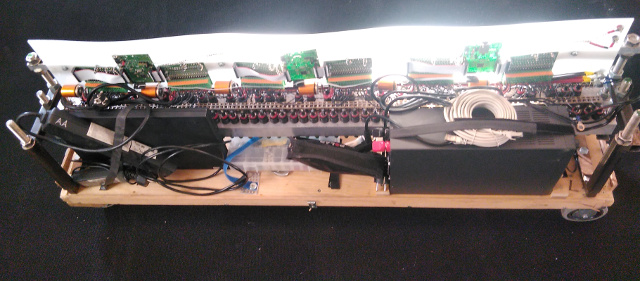
doku/rhea_3rd_generation/montage_rhea/04-aklavier_verbpackt.jpg
