algorythmics/pianoplayer/hardware/escher/production/escher_printed.jpg

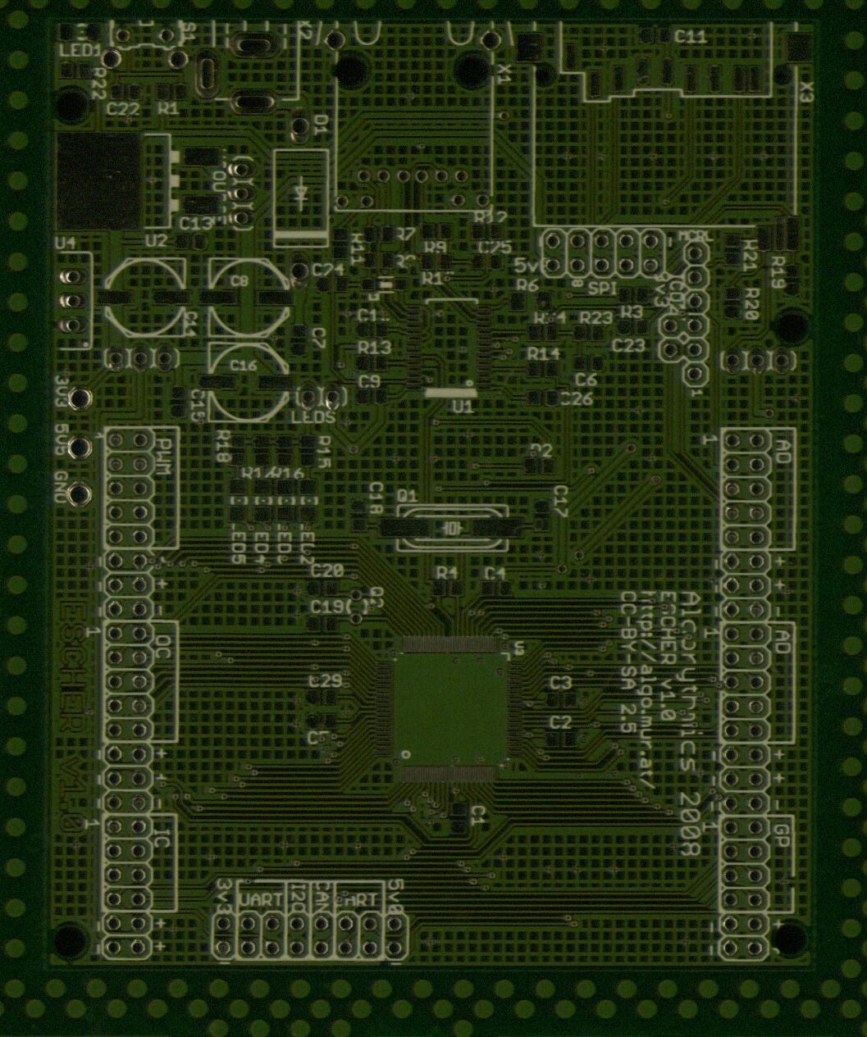
hardware/escher/production/escher_printed.jpg
