algorythmics/pianoplayer/hardware/escherFET16/docu/measurement_60V_FET/messaufbau_48V.jpg

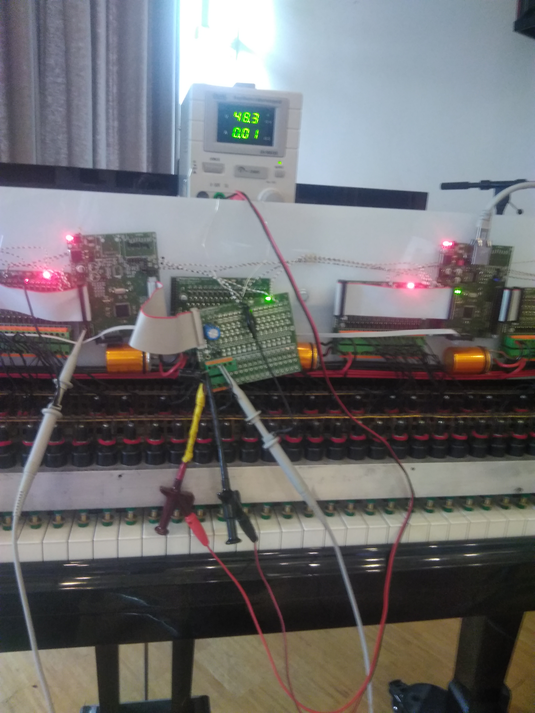
hardware/escherFET16/docu/measurement_60V_FET/messaufbau_48V.jpg
