algorythmics/pianoplayer/hardware/escherFET16/figures/fet16_assembly.png

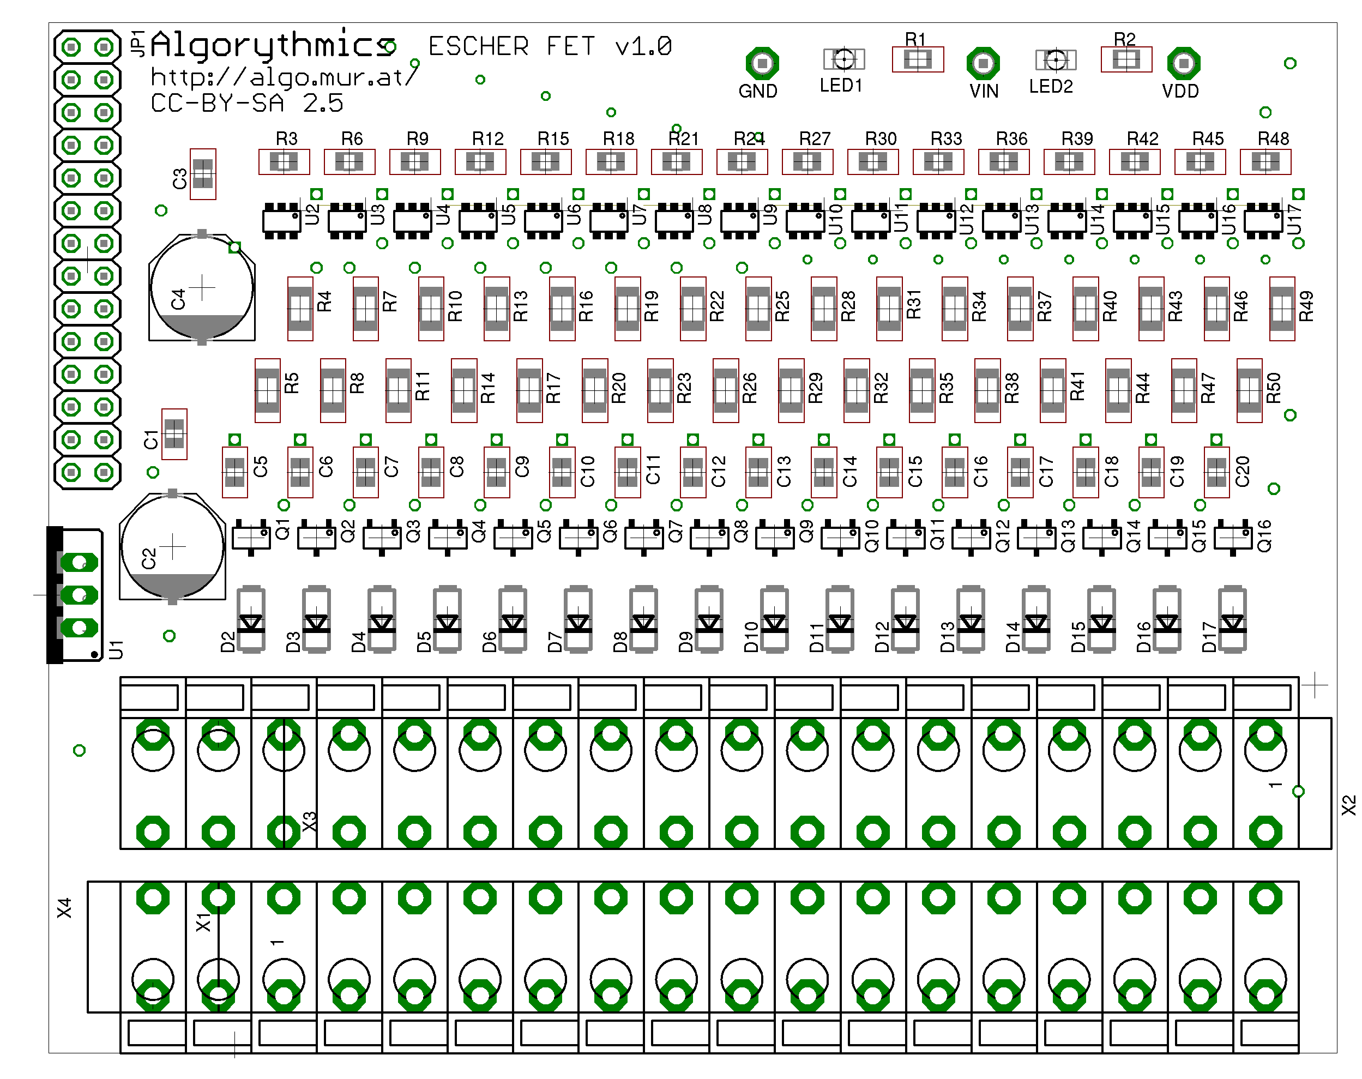
hardware/escherFET16/figures/fet16_assembly.png
