algorythmics/pianoplayer/doku/kantor_first_prototype/fotos/00-first_tests_with_solenoids.jpg

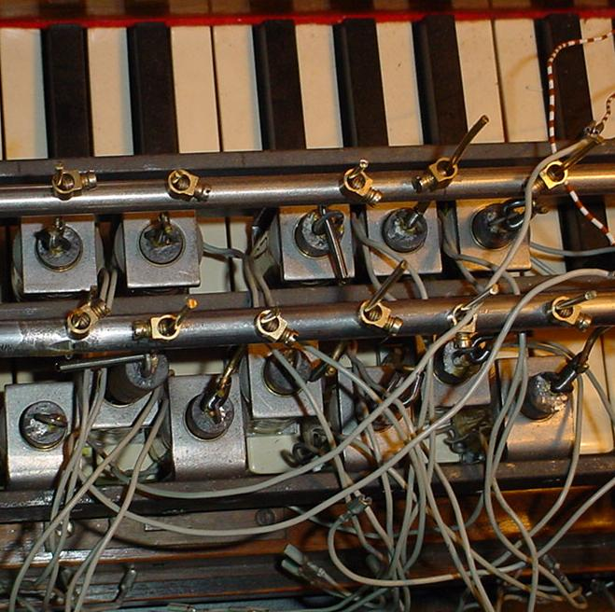
doku/kantor_first_prototype/fotos/00-first_tests_with_solenoids.jpg
