algorythmics/pianoplayer/hardware/escherFET16/docu/measurement_60V_FET/flir/20160811-eschercontroller_5h_playing.jpg

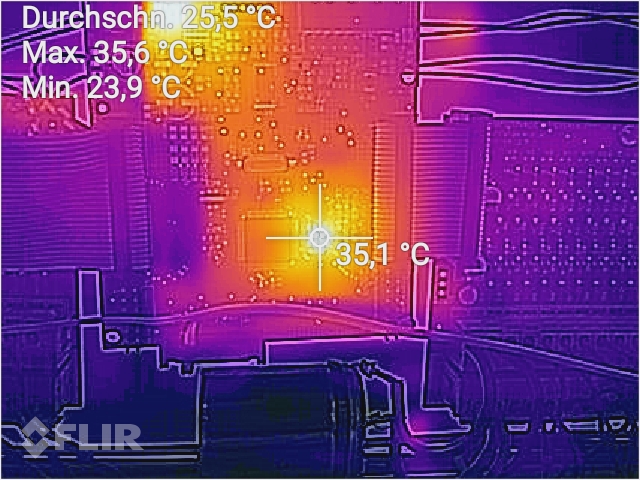
hardware/escherFET16/docu/measurement_60V_FET/flir/20160811-eschercontroller_5h_playing.jpg
