algorythmics/pianoplayer/hardware/escherFET16/docu/measurement_60V_FET/flir/20160811-fetboard_const_play_fet2_1.jpg

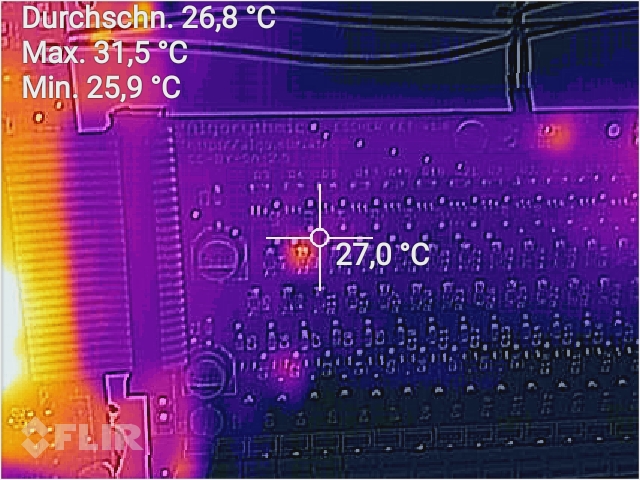
hardware/escherFET16/docu/measurement_60V_FET/flir/20160811-fetboard_const_play_fet2_1.jpg
