algorythmics/pianoplayer/hardware/escherFET16/docu/measurement_60V_FET/flir/20160811-shortcut_fet2_2.jpg

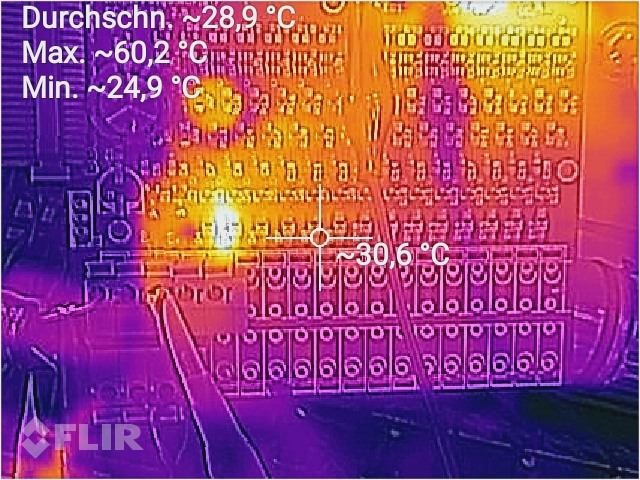
hardware/escherFET16/docu/measurement_60V_FET/flir/20160811-shortcut_fet2_2.jpg
