algorythmics/pianoplayer/hardware/escherFET16/docu/measurement_60V_FET/flir/20160811-solenoid_playing_5h.jpg

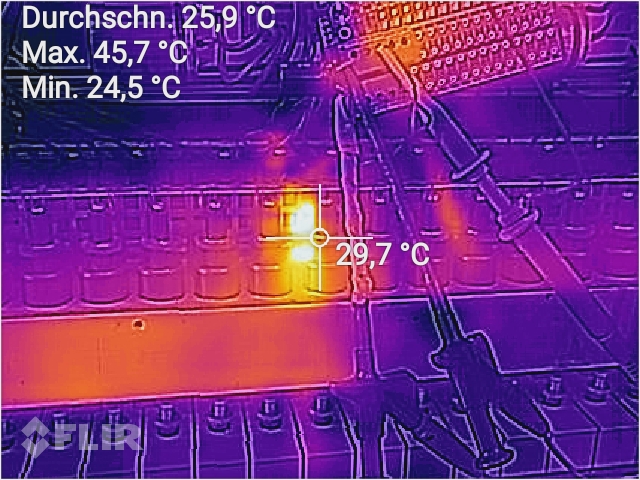
hardware/escherFET16/docu/measurement_60V_FET/flir/20160811-solenoid_playing_5h.jpg
