algorythmics/pianoplayer/hardware/escherFET16/docu/measurement_60V_FET/IMG_20160811_123102.jpg

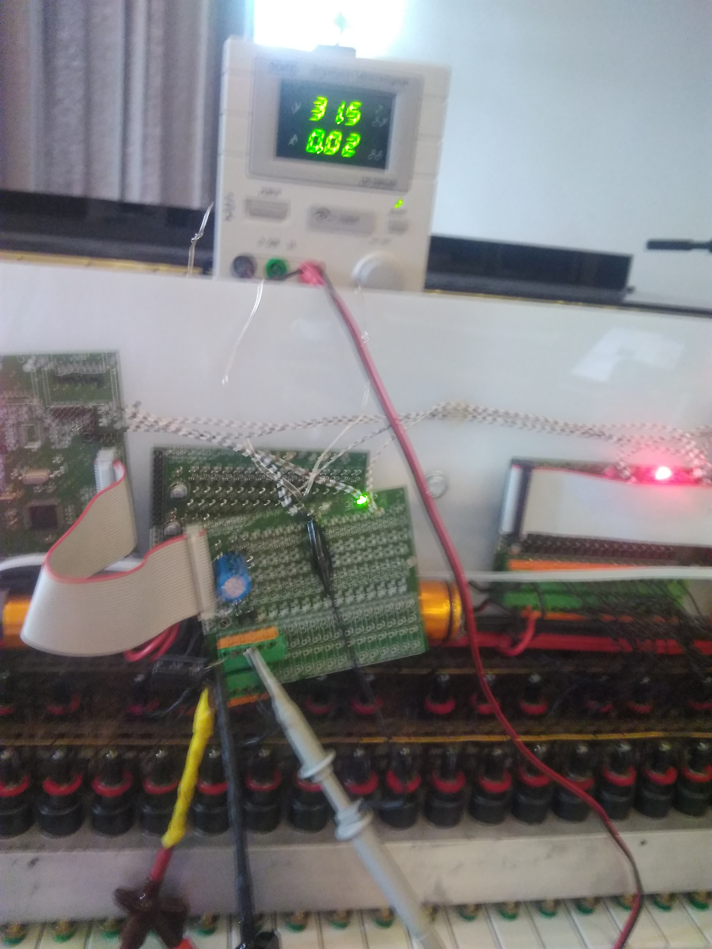
hardware/escherFET16/docu/measurement_60V_FET/IMG_20160811_123102.jpg
