algorythmics/pianoplayer/hardware/escherFET16/docu/measurement_60V_FET/vid_controller.png

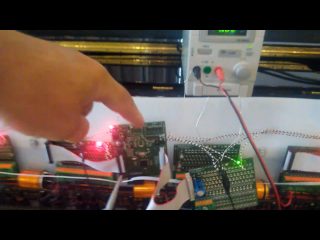
hardware/escherFET16/docu/measurement_60V_FET/vid_controller.png
