algorythmics/pianoplayer/hardware/escherFET16/docu/measurement_60V_FET/vid_fet16_60V.png

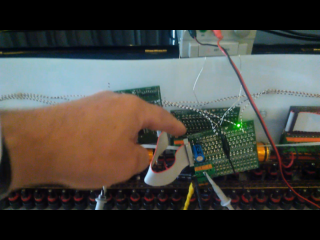
hardware/escherFET16/docu/measurement_60V_FET/vid_fet16_60V.png
