algorythmics/pianoplayer/hardware/escherFET16/docu/measurement_60V_FET/vid_supply_30V.png

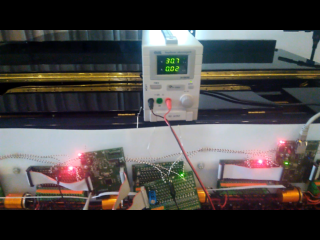
hardware/escherFET16/docu/measurement_60V_FET/vid_supply_30V.png
