algorythmics/pianoplayer/hardware/escherFET16/docu/measurement_knights_solenoids/measurement_22.jpg

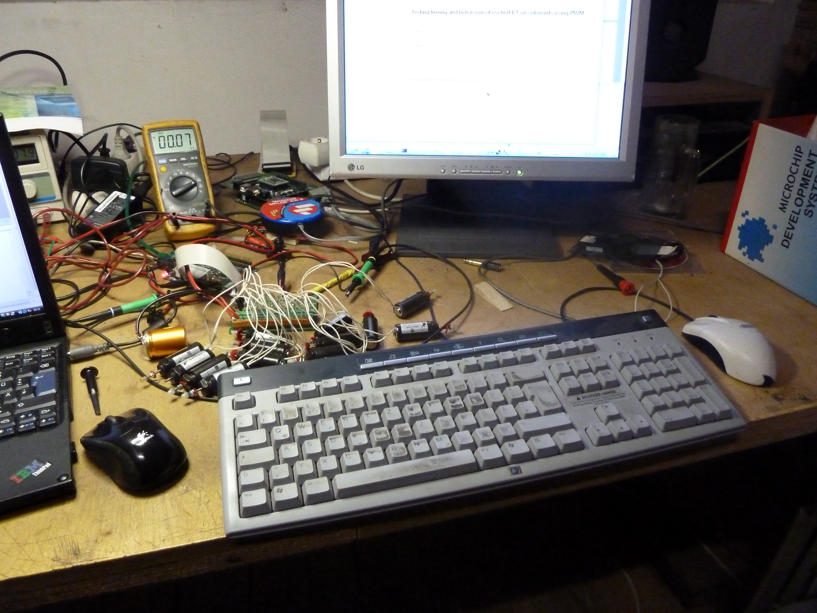
hardware/escherFET16/docu/measurement_knights_solenoids/measurement_22.jpg
