algorythmics/pianoplayer/hardware/solenoids/AO2051S_new2.pdf

## Based on AO-2051S

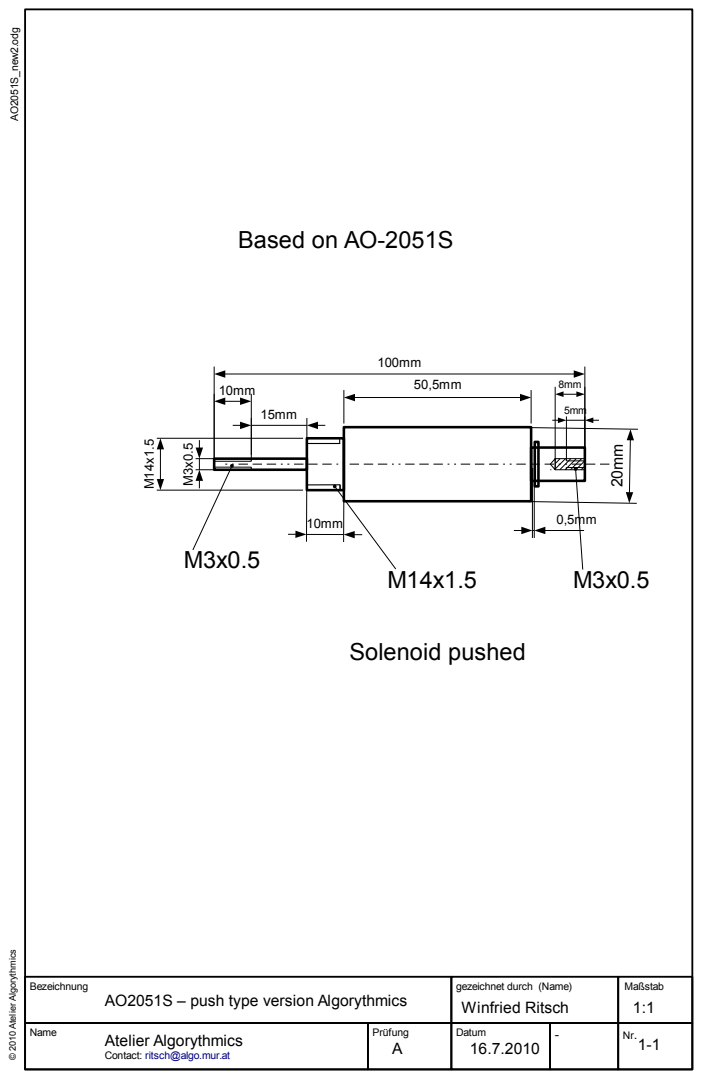
[picture p131: page 1]
© 2010 Atelier Algorythmics A; _new2.odg; Solenoid pushed

Bezeichnung AO2051S – push type version Algorythmics | gezeichnet durch (Name) Winfried Ritsch | Maßstab 1:1

Name Atelier Algorythmics Contact: ritsch@algo.mur.at | Prüfung | Datum 16.7.2010 | - Nr. | 1-1 A
