algorythmics/pianoplayer/hardware/solenoids/AO2051S_new2_cut.pdf

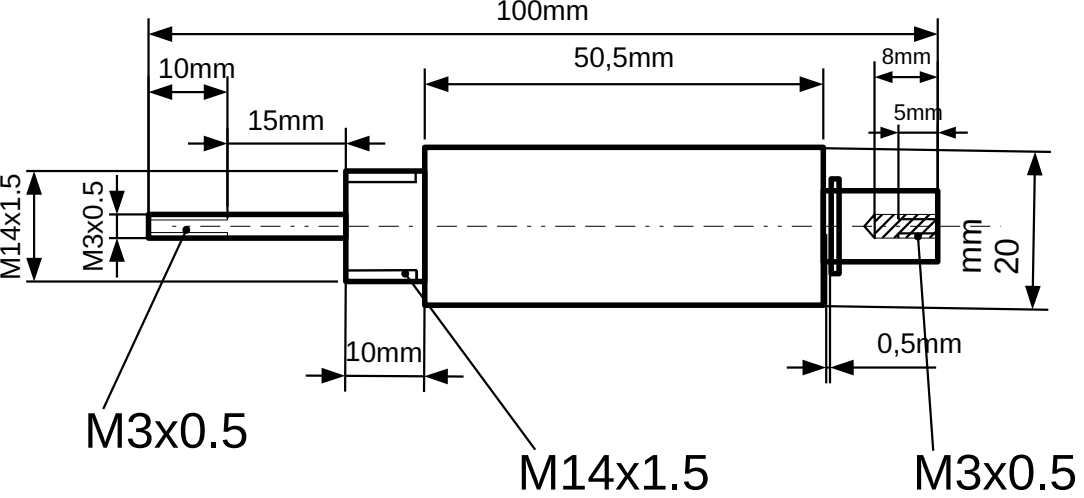
[picture p132: page 1]
