algorythmics/pianoplayer/hardware/escher/production/escher_prototype.pdf

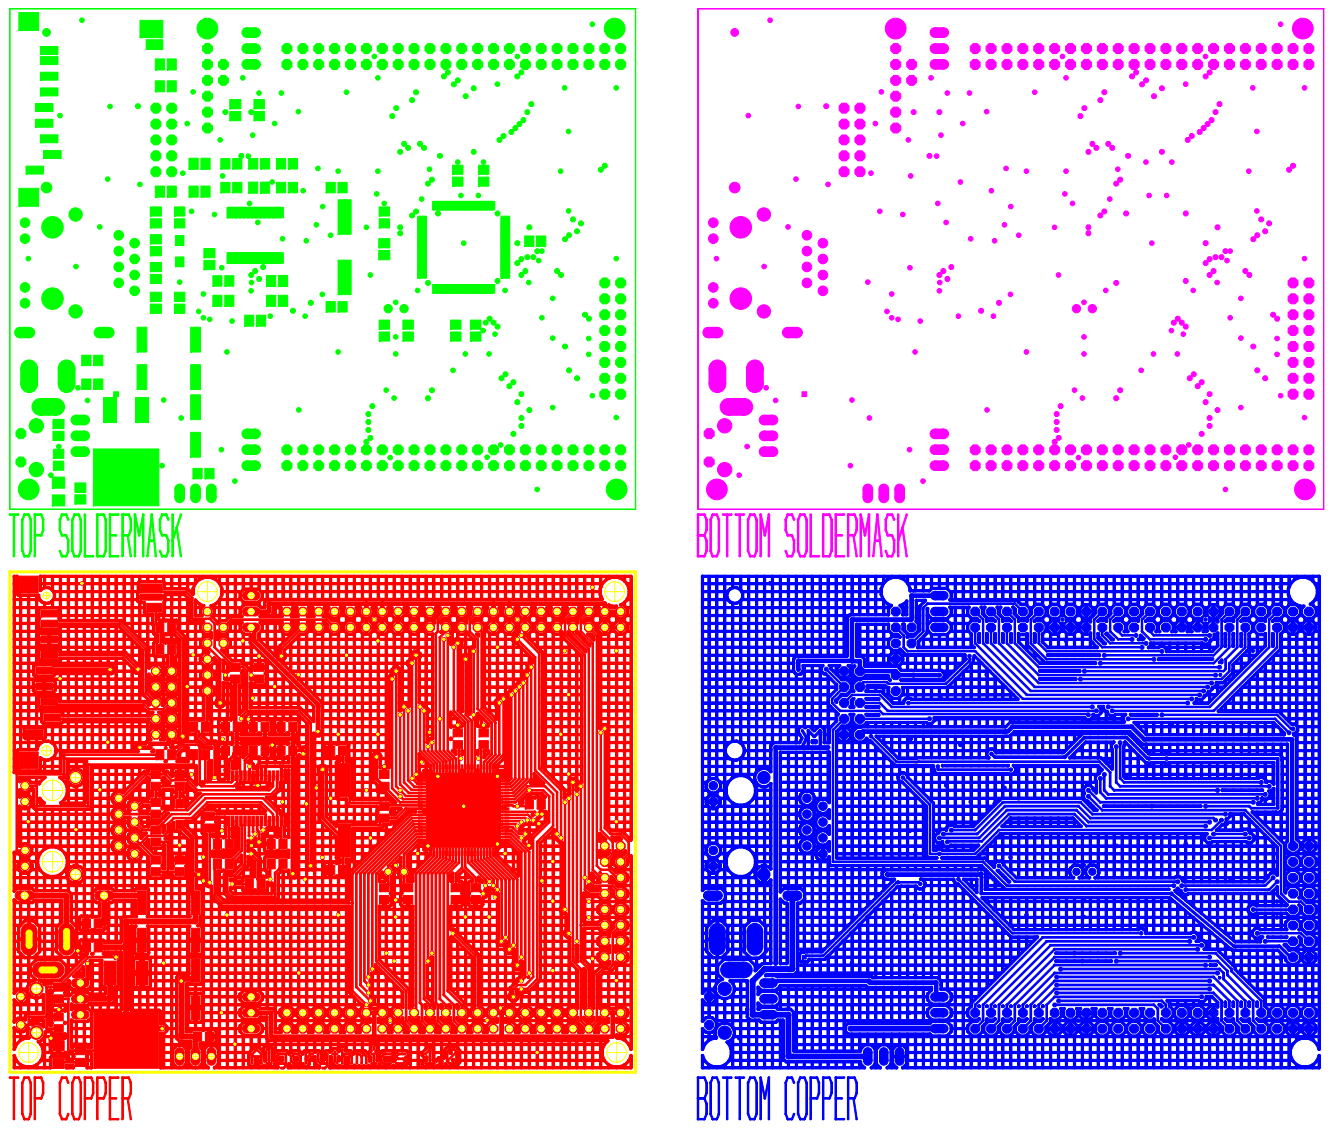
[picture p133: page 1]
