algorythmics/pianoplayer/firmware/escherOS-rhea/RheaPlayer/src/init_timer1.c

/**********************************************************************
* � 2005 Microchip Technology Inc.
*
* FileName:        init_timer1.c
* Dependencies:    Header (.h) files if applicable, see below
* Processor:       dsPIC33Fxxxx/PIC24Hxxxx
*
* SOFTWARE LICENSE AGREEMENT:
* Microchip Technology Incorporated ("Microchip") retains all ownership and 
* intellectual property rights in the code accompanying this message and in all 
* derivatives hereto.  You may use this code, and any derivatives created by 
* any person or entity by or on your behalf, exclusively with Microchip's
* proprietary products.  Your acceptance and/or use of this code constitutes 
* agreement to the terms and conditions of this notice.
*
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
* YOU ACKNOWLEDGE AND AGREE THAT, IN NO EVENT, SHALL MICROCHIP BE LIABLE, WHETHER 
* IN CONTRACT, WARRANTY, TORT (INCLUDING NEGLIGENCE OR BREACH OF STATUTORY DUTY), 
* STRICT LIABILITY, INDEMNITY, CONTRIBUTION, OR OTHERWISE, FOR ANY INDIRECT, SPECIAL, 
* PUNITIVE, EXEMPLARY, INCIDENTAL OR CONSEQUENTIAL LOSS, DAMAGE, FOR COST OR EXPENSE OF 
* ANY KIND WHATSOEVER RELATED TO THE CODE, HOWSOEVER CAUSED, EVEN IF MICROCHIP HAS BEEN 
* ADVISED OF THE POSSIBILITY OR THE DAMAGES ARE FORESEEABLE.  TO THE FULLEST EXTENT 
* ALLOWABLE BY LAW, MICROCHIP'S TOTAL LIABILITY ON ALL CLAIMS IN ANY WAY RELATED TO 
* THIS CODE, SHALL NOT EXCEED THE PRICE YOU PAID DIRECTLY TO MICROCHIP SPECIFICALLY TO 
* HAVE THIS CODE DEVELOPED.
*
* You agree that you are solely responsible for testing the code and 
* determining its suitability.  Microchip has no obligation to modify, test, 
* certify, or support the code.
*
* REVISION HISTORY:
*~~~~~~~~~~~~~~~~~~~~~~~~~~~~~~~~~~~~~~~~~~~~~~~~~~~~~~~~~~~~~~~~~~~~~~
* Author            Date      Comments on this revision
*~~~~~~~~~~~~~~~~~~~~~~~~~~~~~~~~~~~~~~~~~~~~~~~~~~~~~~~~~~~~~~~~~~~~~~
* Richard Fischer   07/18/05  Initialization of Timer1 for RTC demo
*
*~~~~~~~~~~~~~~~~~~~~~~~~~~~~~~~~~~~~~~~~~~~~~~~~~~~~~~~~~~~~~~~~~~~~~~
*
* ADDITIONAL NOTES:
*
*
**********************************************************************/

#if defined(__dsPIC33F__)
#include "p33FJ128MC708A.h"
#elif defined(__PIC24H__)
#include "p24hxxxx.h"
#endif
   
extern void enSecOsc();
 
/*---------------------------------------------------------------------
  Function Name: Init_Timer1
  Description:   Initialize Timer1 for 1 second intervals
  Inputs:        None
  Returns:       None
-----------------------------------------------------------------------*/
void Init_Timer1( void )
{
    T1CON = 0;              // Timer reset
 	IFS0bits.T1IF = 0;      // Reset Timer1 interrupt flag
	IPC0bits.T1IP = 4;      // Timer1 Interrupt priority level=4
 	IEC0bits.T1IE = 1;      // Enable Timer1 interrupt
 	  	
	PR1 = 0x8000;           // Timer1 period register = 32768
	T1CONbits.TCS = 1;      // Timer1 Clock= External   
    enSecOsc();             // Enable Secondary Osc
	T1CONbits.TON = 1;      // Enable Timer1 and start the counter
}
