algorythmics/pianoplayer/(commit log)

2017-12-20 first structure and collection of hard and software for a first open source hardware and software release
    [ALGO_dsPIC.brd, ALGO_dsPIC.sch, algo_fet16.brd, algo_fet16.csv, algo_fet16.sch, hubmagnete_messurements-for_firmware.ods]
2019-05-11 added fet pinout for debug
2019-07-15 added fotos for new springs
2024-05-03 changed format for better distribution
    [tastenabstaende.ods]
2025-09-09 new dev boards folder
2025-09-09 cut and rotated
